hubbellc/ECE44x/README.txt

This is the root folder.
From here you can navigate to a number of well-named folders, containing (hopefully) what you are looking for.
