hubbellc/ECE44x/PCB/README.txt

This folder contains everything utilized in the development of the PCB.
Here you have some basic schematics and images, and then three folders:
	Power holds all the power circuit design
	PCB holds the actual CAD files
		Open using Kicad
	Wiring Design holds the preliminary wiring to get LoRa working
