hubbellc/ECE44x/Wireless Communication/README.txt

This folder contains the user manuals for the Wireless Modules, as well as a variety of testing outputs, and a LoRa range estimator.
