hubbellc/ECE44x/PCB/Power/README.txt

This folder contains all of the power designs.

Progams:
	.asc = LTspice
	
Folder = the kicad design files
	All files in here open in kicad
