hubbellc/ECE44x/Sensor/Sensor Housing/README.txt

This folder contains all files utilized in designing the Sensor Housing.
All files were made using SolidWorks.
There are two additional folders in here, they are included parts that I found online.
