hubbellc/ECE44x/Sensor/Sensor Processing/Sensor Code/README.txt

This is the master folder for all Sensor Code.
It holds a backup of working code, a variety of arduino code, and two additional folders (excluding the arduino file folders).
These two are: Sensor Sandbox, and  Included Libraries.
