hubbellc/ECE44x/Sensor/Sensor Processing/Sensor Code/Included libraries/README.txt

This folder contains all libraries necessary to run the main code "Teensy_Code".
