hubbellc/ECE44x/Sensor/Sensor Processing/Sensor Code/Sensor Sandbox/README.txt

This folder contains all files utilized in testing our integrated sensors.
Play with things!
