hubbellc/ECE44x/Receiver/Receiver Code/cloudtest.docx

The python code below shows the loop that runs on it’s own thread and will upload to the cloud in a loop based on a timer.
