hubbellc/ECE44x/Receiver/Receiver Housing/Housing Ideas.docx

https://www.amazon.com/dp/B07B5ZVS7H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 (https://www.amazon.com/dp/B07B5ZVS7H?s=wireless)

https://www.amazon.com/Raspberry-Case-Black-Compatible-Model/dp/B00UW2G1BS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

Just remove block? Allowed?

Keep shopping.. Look at digikey

https://www.digikey.com/products/en?keywords=raspberry%20pi%203%20case

https://www.digikey.com/products/en/power-supplies-external-internal-off-board/ac-dc-desktop-wall-adapters/130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

https://www.digikey.com/product-detail/en/globtek-inc/WR9MA2000USB-F-R6B/1939-1478-ND/8598281

https://www.digikey.com/products/en/boxes-enclosures-racks/evaluation-development-board-enclosures/975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
