hubbellc/ECE44x/Sensor/Sensor Processing/ch4.docx

I tested the CH4 by hitting the sensor with a blowtorch (with the flame obviously not sparked). The sensor should react to that as it reacts to multiple types of flammable gases including butane. The following data point was taken before and after the blowtorch turned on:

Date/time | Temp | Humidity | Air pressure | Lux | NO2 | CH4
4/18/2019 18:08:13 | 24 | 27 | 101 | 110 | 1 | 30
4/18/2019 18:10:28 | 24 | 28 | 101 | 60 | 1 | 64
