hubbellc/ECE44x/Generated Images/Poster Block Diagram.jpg

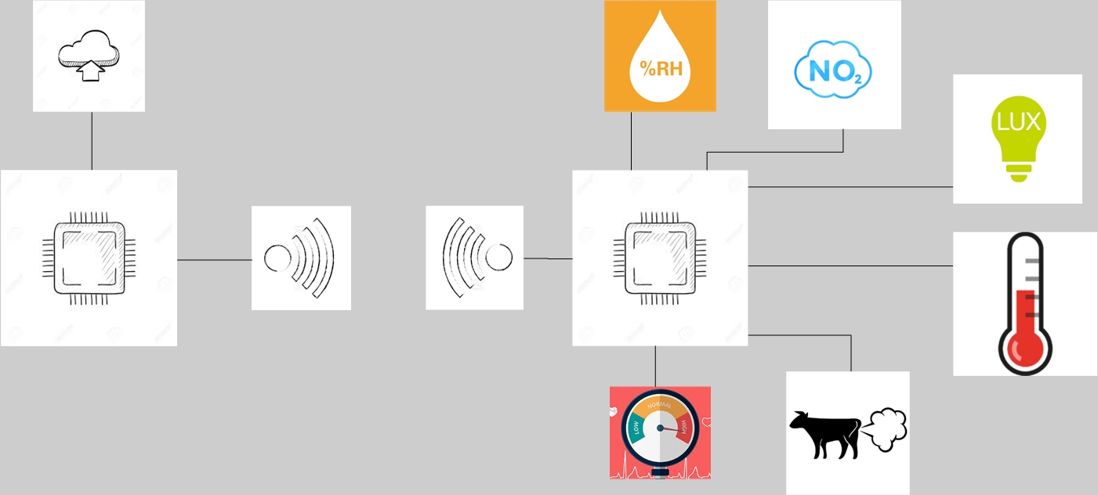
Generated Images/Poster Block Diagram.jpg
