hubbellc/ECE44x/PCB/pcb_pic.PNG

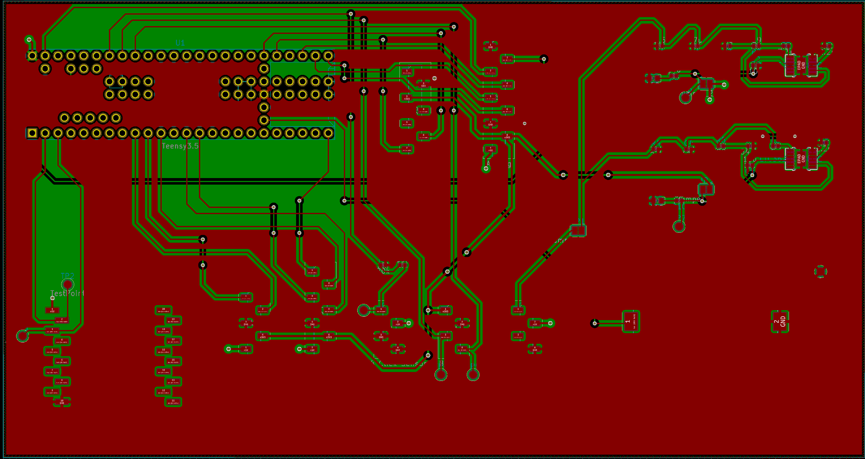
PCB/pcb_pic.PNG
