hubbellc/ECE44x/PCB/Power/power_block.PNG

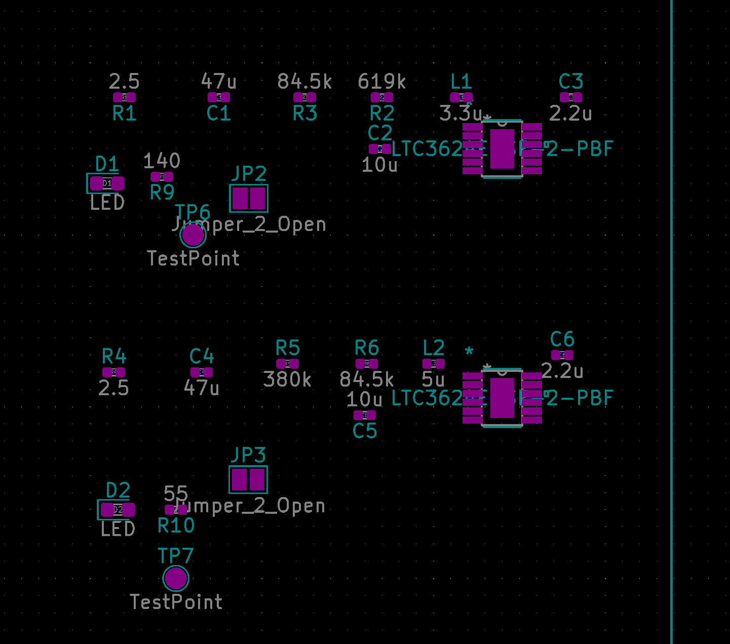
PCB/Power/power_block.PNG
