hubbellc/ECE44x/Sensor/Sensor Housing/Considerations.xlsx

Interface | Item | Size | Panel Thickness | Datasheet | To Buy: | Other Modifications
240V AC PWR | Qualtek 771W-X2/01 | Rectangular - 24.50mm x 12.50mm | (0.60mm ~ 1.50mm) | http://www.qualtekusa.com/images/AC_Receptacles/pdfs/771wx201.pdf | https://octopart.com/search?q=%20Qualtek%20771W-X2%2F01 | Nail Hole (2) | TRUE
12V DC PWR | GC Electronics 33-1402 | Rectangular - 57mm x 57mm | N/A | https://media.digikey.com/pdf/Data%20Sheets/GC%20Electronics%20PDFs/33-1402_Dwg.pdf | https://octopart.com/search?q=GC%20Electronics%2033-1402 | Air ventilation | TRUE
Antenna conn | PulseLarsen Antennas W9011M | 5.49mm circle | N/A | https://productfinder.pulseeng.com/doc_type/WEB301/doc_num/W90XX/doc_part/W90XX.pdf | https://octopart.com/search?q=W9011M | Light window | TRUE
 |  |  |  |  |  | Power components? | TRUE
US plug: | Phihong USA AC15WNA | N/A | N/A | https://media.digikey.com/pdf/Data%20Sheets/Phihong%20PDFs/AC15WNA.pdf | https://octopart.com/search?q=Phihong%20USA%20AC15WNA
Thailand plug: | Phihong USA AC15WEU | N/A | N/A | https://media.digikey.com/pdf/Data%20Sheets/Phihong%20PDFs/AC_Line_Cords.pdf | https://octopart.com/search?q=Phihong%20USA%20AC15WEU
Antenna | PulseLarsen Antennas SPDA24918 | N/A | N/A | http://productfinder.pulseeng.com/products/datasheets/SPDA24918.pdf | https://octopart.com/search?q=SPDA24918
