hubbellc/ECE44x/Sensor/Sensor Processing/SD Card Space.xlsx

Size: | Amount: | Size per write: | Max: | Writes: | Writes a day: | Days of writes: | Years of writes:
1.2 | 31 | 0.03871 | 8000000 | 207000000 | 288 | 718000 | 1910
KB |  | KB | KB
