hubbellc/ECE44x/Sensor/Sensor Housing/hirose-u-fl-female-jack-to-sma-female-jack-bulkhead-rf-adapter-1.snapshot.6/U.FL Female Jack to SMA Female Jack Bulkhead RF Connector.SLDASM

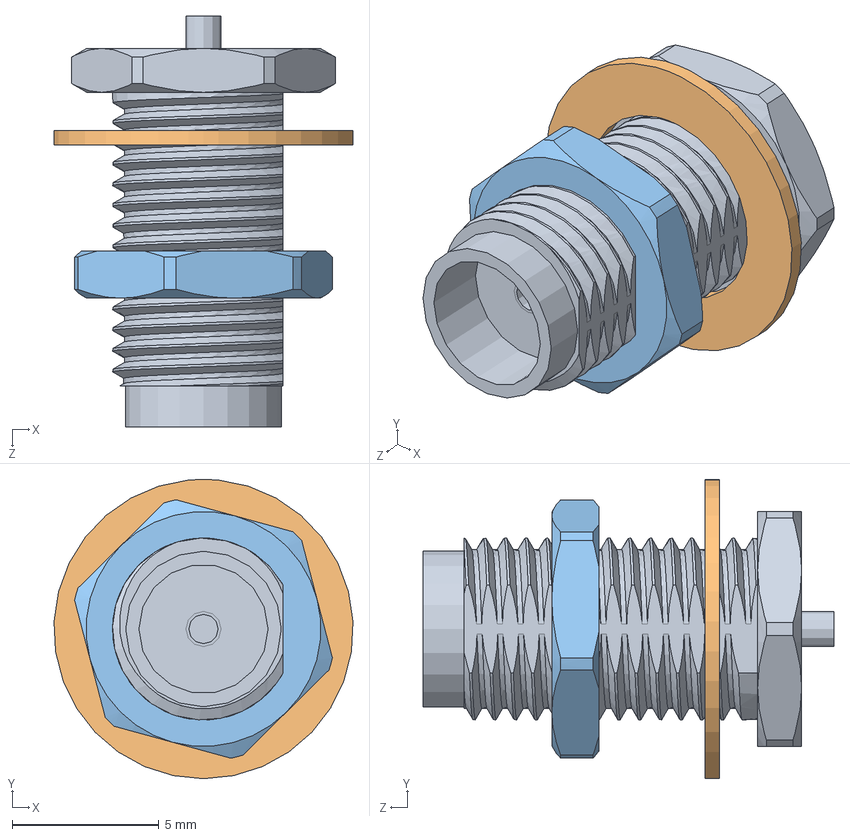
[picture p4: CAD file, 2019-02-04]
Sensor/Sensor Housing/hirose-u-fl-female-jack-to-sma-female-jack-bulkhead-rf-adapter-1.snapshot.6/U.FL Female Jack to SMA Female Jack Bulkhead RF Connector.SLDASM
10.2 x 10.2 x 14.0 mm
U.FL to SMA Bulkhead
U.FL to SMA Bulkhead Washer
U.FL to SMA Bulkhead Nut
