hubbellc/ECE44x/Sensor/Sensor Housing/Sensor Housing.SLDASM

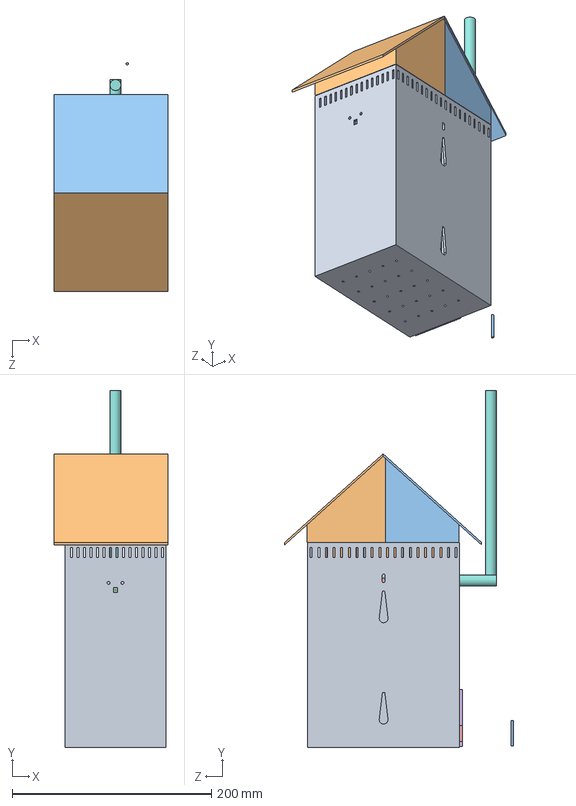
[picture p5: CAD file, 2019-05-01]
Sensor/Sensor Housing/Sensor Housing.SLDASM
114.3 x 358.1 x 229.4 mm
Base
Door
Light sensor
AC Plug
DC Plug
U.FL to SMA Bulkhead
Antenna
Light sensor washers
Roof1
Roof2
PCB Holder
SOLID.step x 2
SOLID-0.step x 10
SOLID-1.step x 2
SOLID-2.step
SOLID-3.step x 3
SOLID-4.step
SOLID-5.step x 6
SOLID-6.step x 2
COMPOUND.step
