hubbellc/ECE44x/Sensor/Sensor Housing/PCB.SLDASM

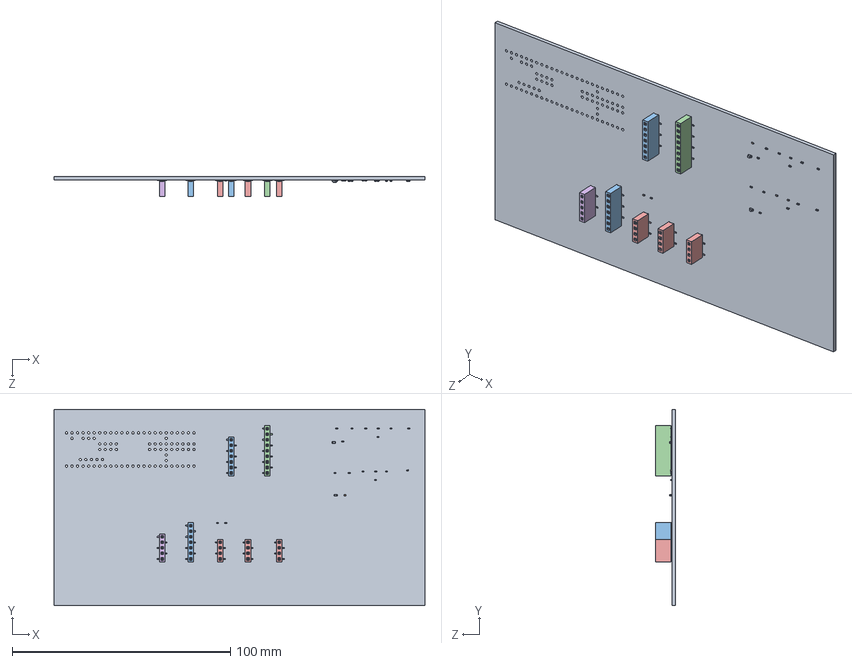
[picture p6: CAD file, 2019-05-01]
Sensor/Sensor Housing/PCB.SLDASM
170.0 x 90.0 x 9.05 mm
SOLID.step x 2
SOLID-0.step x 10
SOLID-1.step x 2
SOLID-2.step
SOLID-3.step x 3
SOLID-4.step
SOLID-5.step x 6
SOLID-6.step x 2
COMPOUND.step
