hubbellc/ECE44x/Sensor/Sensor Housing/House on post.SLDASM

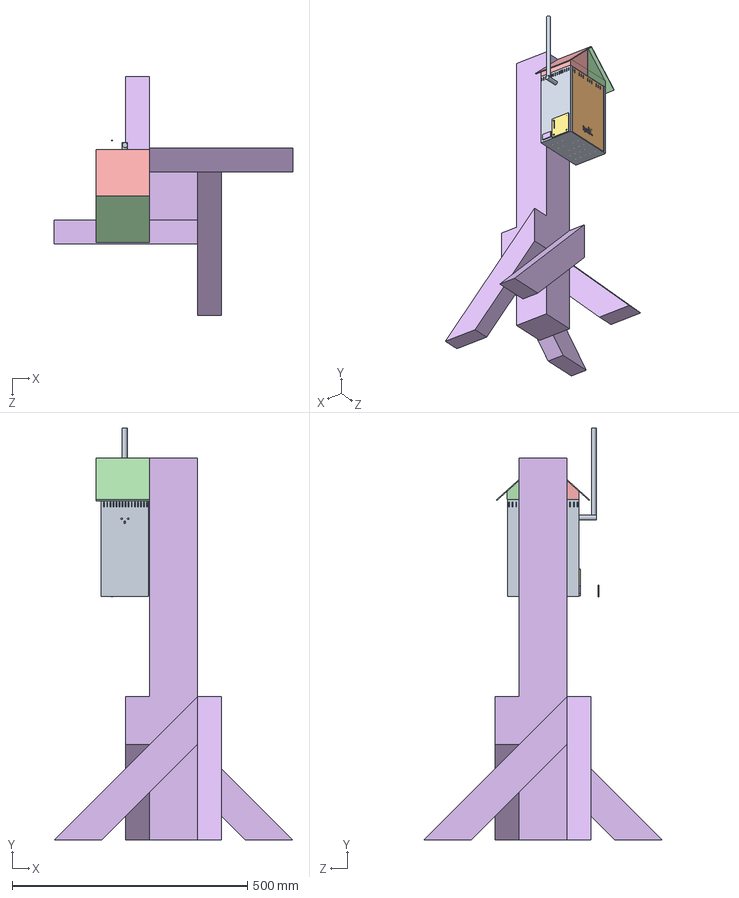
[picture p7: CAD file, 2019-02-22]
Sensor/Sensor Housing/House on post.SLDASM
508.0 x 876.3 x 508.0 mm
Base
Door
PCB
Light sensor
AC Plug
DC Plug
U.FL to SMA Bulkhead
Antenna
PCB washers
Light sensor washers
Roof1
Roof2
Stand
