hubbellc/ECE44x/Generated Images/raitong-intro-logo-detailed.dxf

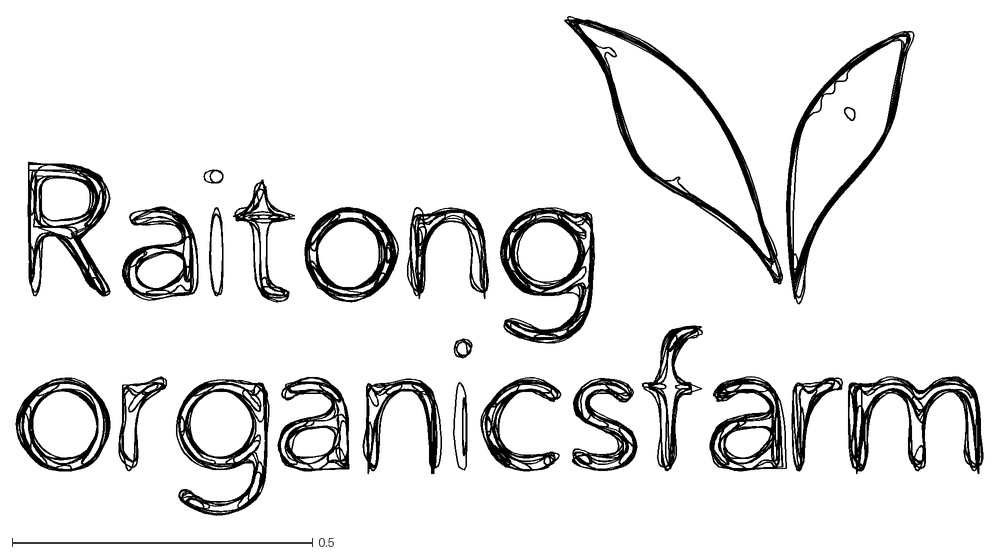
[picture p8: CAD file, 2019-02-14]
Generated Images/raitong-intro-logo-detailed.dxf
1.62 x 0.831
