hubbellc/ECE44x/Sensor/Sensor Housing/User Library-VEML6070_UV/User Library-VEML6070_UV.SLDPRT

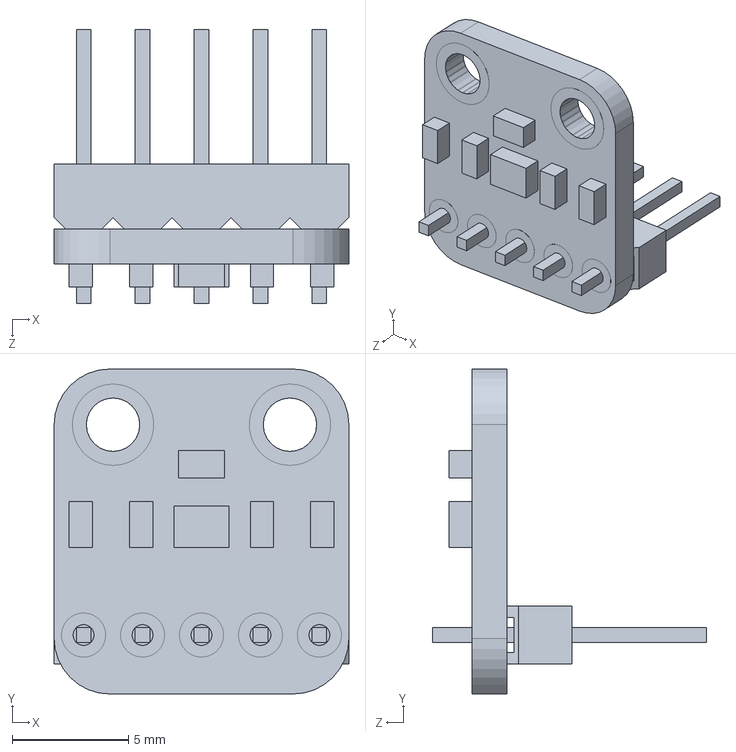
[picture p9: CAD file, 2019-02-04]
Sensor/Sensor Housing/User Library-VEML6070_UV/User Library-VEML6070_UV.SLDPRT
12.7 x 14.0 x 11.8 mm
