hubbellc/ECE44x/Generated Images/raitong-intro-logo-simple.dxf

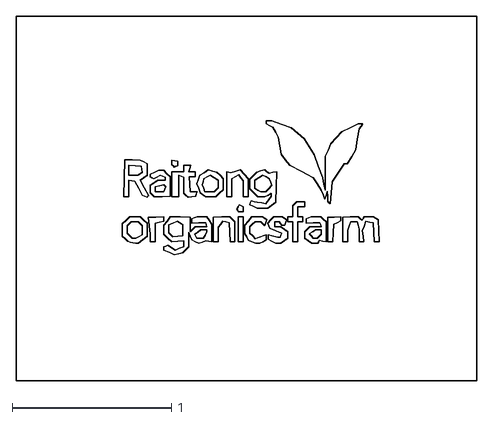
[picture p10: CAD file, 2019-02-14]
Generated Images/raitong-intro-logo-simple.dxf
2.90 x 2.29
