hubbellc/ECE44x/Sensor/Sensor Housing/Light sensor.SLDPRT

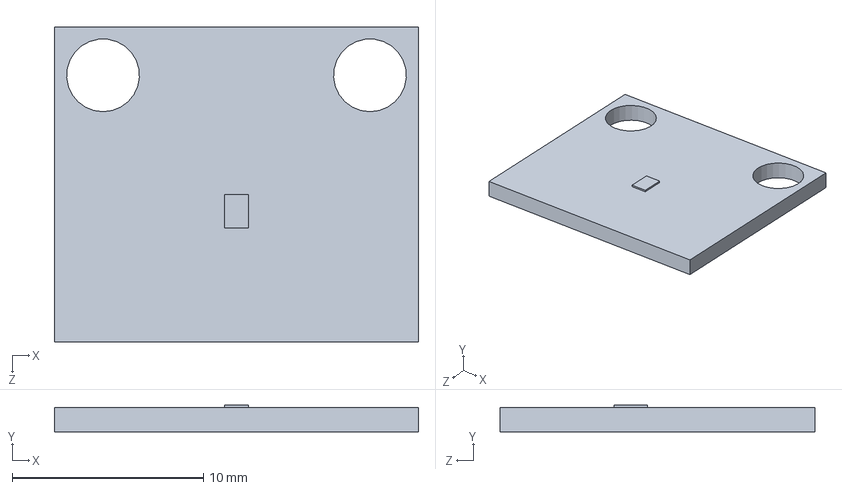
[picture p11: CAD file, 2019-05-01]
Sensor/Sensor Housing/Light sensor.SLDPRT
19.0 x 1.40 x 16.5 mm
