hubbellc/ECE44x/Sensor/Sensor Housing/hirose-u-fl-female-jack-to-sma-female-jack-bulkhead-rf-adapter-1.snapshot.6/U.FL to SMA Bulkhead.SLDPRT

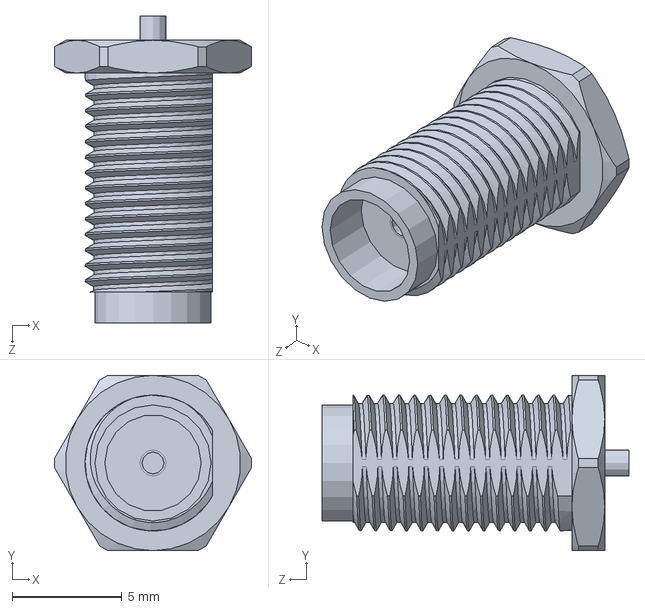
[picture p12: CAD file, 2019-02-04]
Sensor/Sensor Housing/hirose-u-fl-female-jack-to-sma-female-jack-bulkhead-rf-adapter-1.snapshot.6/U.FL to SMA Bulkhead.SLDPRT
8.99 x 8.00 x 14.0 mm
