hubbellc/ECE44x/Sensor/Sensor Housing/Door no logo.SLDPRT

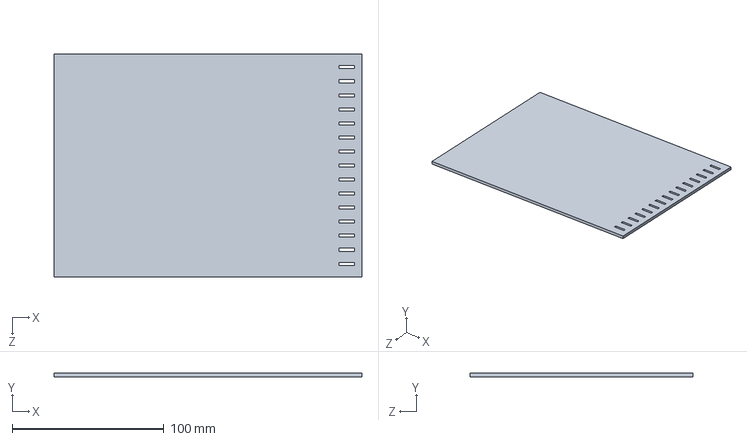
[picture p13: CAD file, 2019-04-10]
Sensor/Sensor Housing/Door no logo.SLDPRT
203.2 x 2.54 x 146.9 mm
