hubbellc/ECE44x/Sensor/Sensor Housing/PCB Holder.SLDPRT

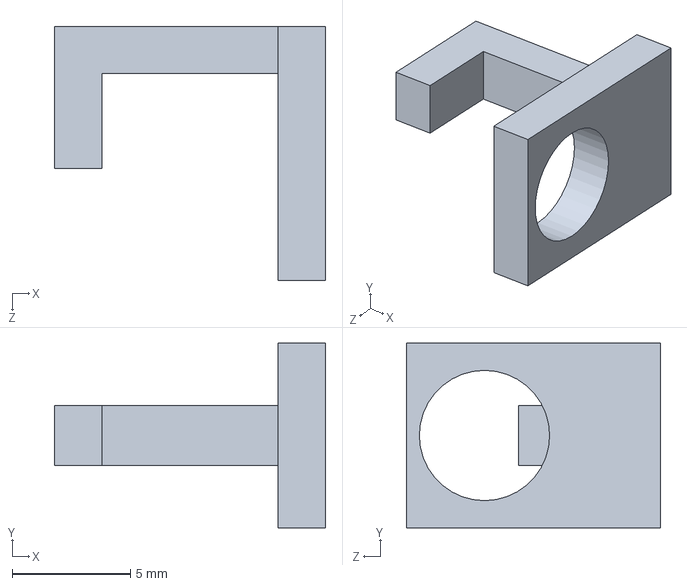
[picture p14: CAD file, 2019-04-10]
Sensor/Sensor Housing/PCB Holder.SLDPRT
11.4 x 7.81 x 10.7 mm
