hubbellc/ECE44x/Sensor/Sensor Housing/Base.SLDPRT

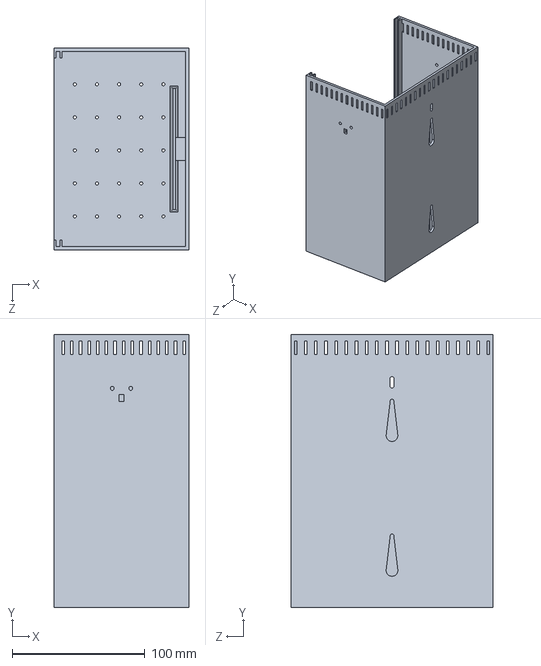
[picture p15: CAD file, 2019-04-10]
Sensor/Sensor Housing/Base.SLDPRT
101.6 x 205.7 x 152.4 mm
