hubbellc/ECE44x/Sensor/Sensor Housing/Stand.SLDPRT

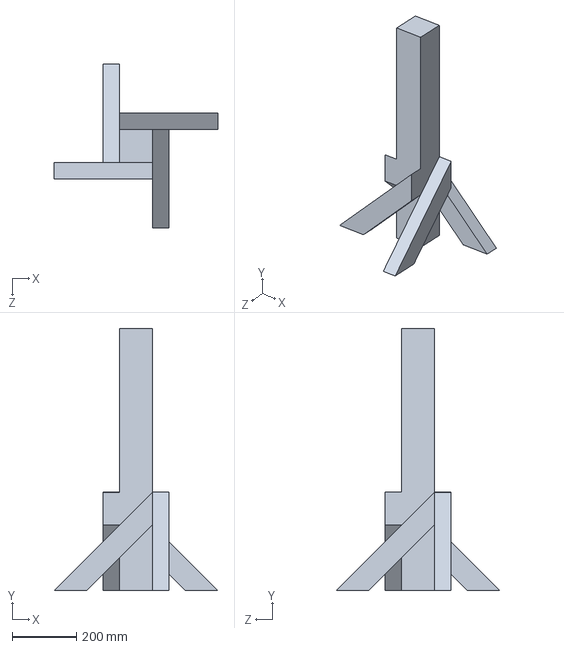
[picture p16: CAD file, 2019-02-22]
Sensor/Sensor Housing/Stand.SLDPRT
508.0 x 812.8 x 508.0 mm
