hubbellc/ECE44x/Sensor/Sensor Housing/Roof1.sldprt

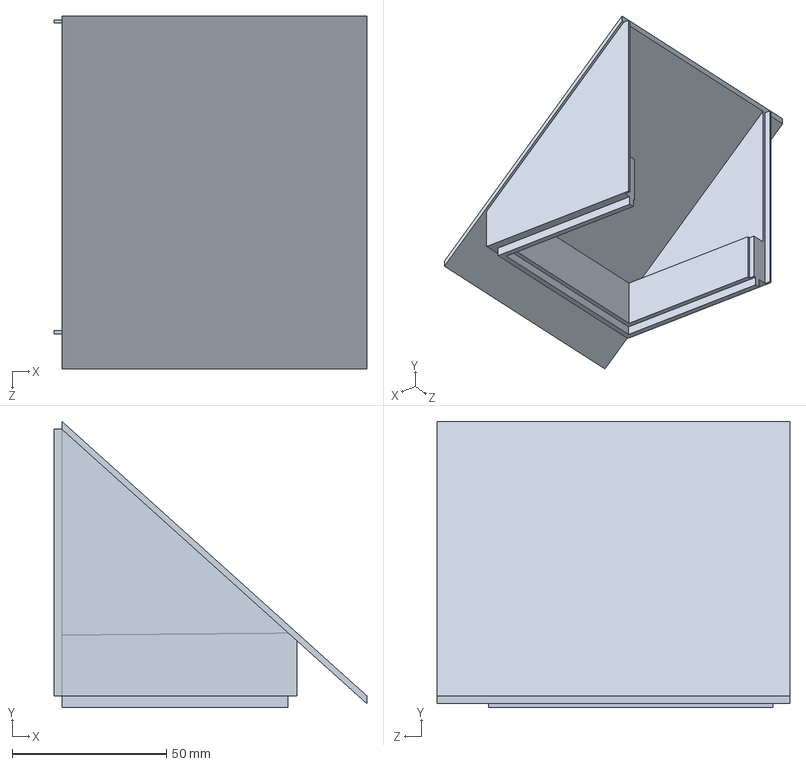
[picture p17: CAD file, 2019-02-22]
Sensor/Sensor Housing/Roof1.sldprt
101.3 x 92.7 x 114.3 mm
