hubbellc/ECE44x/Sensor/Sensor Housing/Roof.SLDPRT

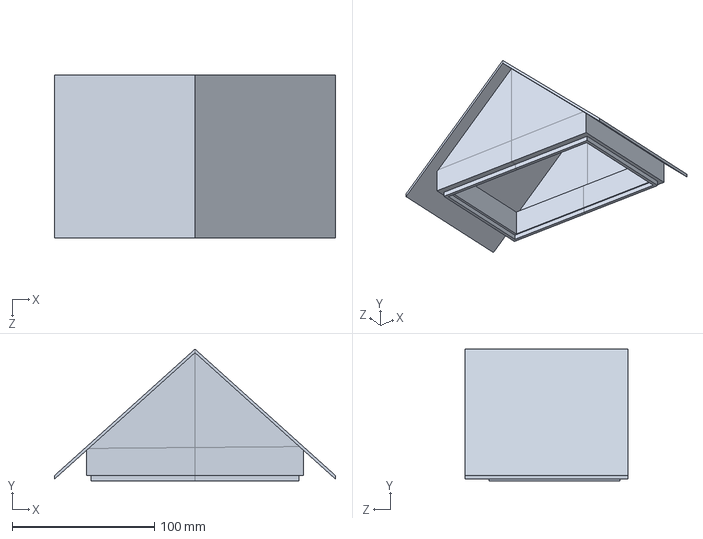
[picture p18: CAD file, 2019-02-22]
Sensor/Sensor Housing/Roof.SLDPRT
197.6 x 92.7 x 114.3 mm
