hubbellc/ECE44x/Sensor/Sensor Housing/Gecko.SLDPRT

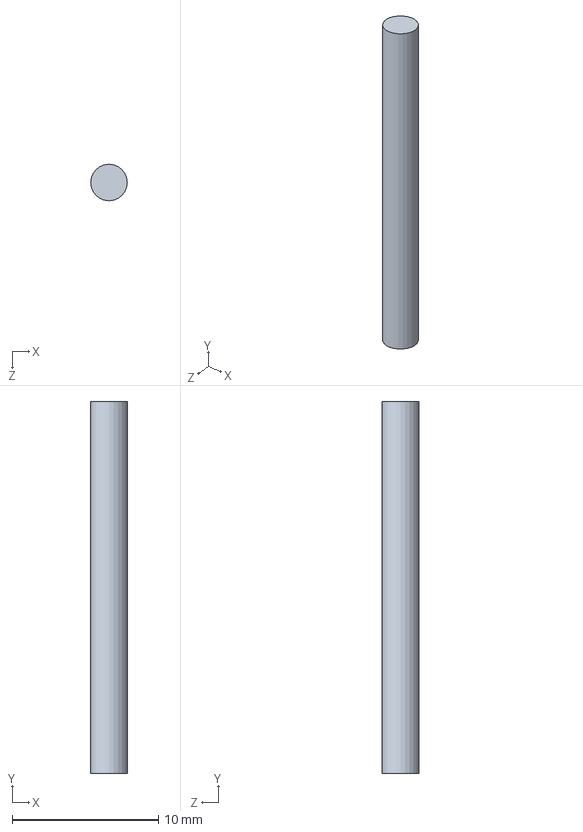
[picture p19: CAD file, 2019-02-14]
Sensor/Sensor Housing/Gecko.SLDPRT
2.50 x 25.4 x 2.50 mm
