hubbellc/ECE44x/Sensor/Sensor Housing/Antenna.SLDPRT

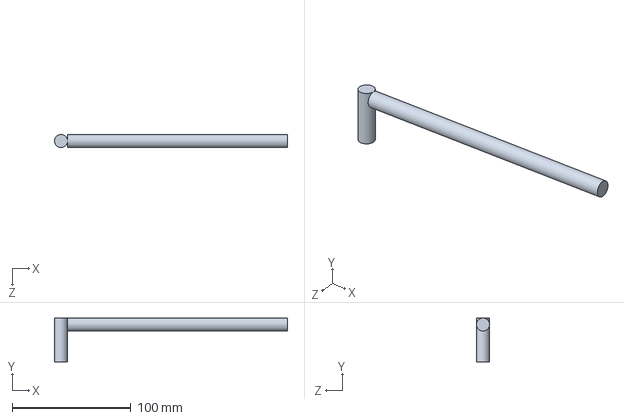
[picture p20: CAD file, 2019-02-14]
Sensor/Sensor Housing/Antenna.SLDPRT
196.0 x 37.0 x 11.0 mm
