hubbellc/ECE44x/Sensor/Sensor Housing/AC Plug.SLDPRT

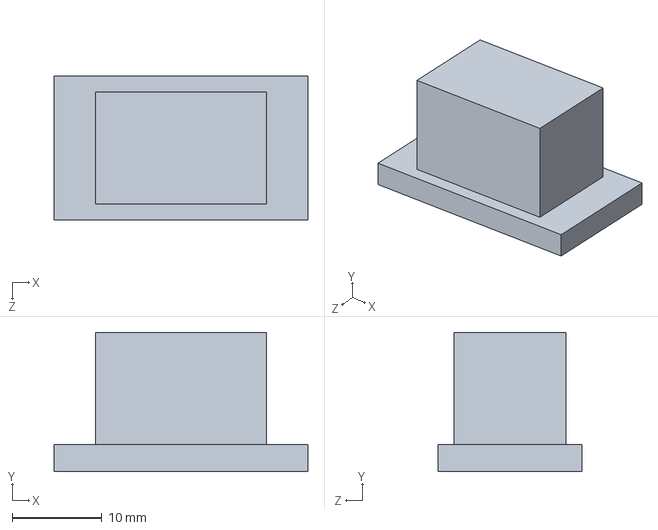
[picture p21: CAD file, 2019-02-14]
Sensor/Sensor Housing/AC Plug.SLDPRT
28.3 x 15.5 x 16.0 mm
