hubbellc/ECE44x/Sensor/Sensor Housing/DC Plug.SLDPRT

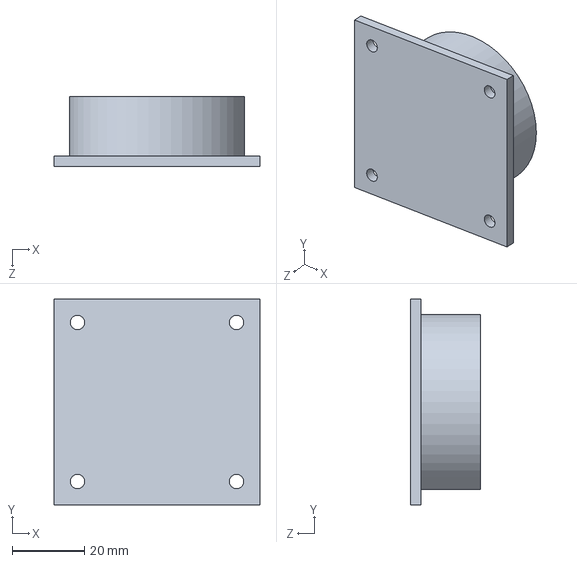
[picture p22: CAD file, 2019-02-04]
Sensor/Sensor Housing/DC Plug.SLDPRT
57.0 x 57.0 x 19.5 mm
