hubbellc/ECE44x/(list of files, cad)

Other CAD files:
Sensor/Sensor Housing/Door.SLDPRT
Sensor/Sensor Housing/Roof2.sldprt
Sensor/Sensor Housing/Base.STL
Sensor/Sensor Housing/Door no logo.DXF
Sensor/Sensor Housing/Door.STL
Sensor/Sensor Housing/Gecko.STL
Sensor/Sensor Housing/Light sensor washers.SLDPRT
Sensor/Sensor Housing/Light sensor washers.STL
Sensor/Sensor Housing/PCB Holder.STL
Sensor/Sensor Housing/PCB washers.SLDPRT
Sensor/Sensor Housing/PCB washers.STL
Sensor/Sensor Housing/PCB.SLDPRT
Sensor/Sensor Housing/Roof1.STL
Sensor/Sensor Housing/Roof2.STL
Sensor/Sensor Housing/hirose-u-fl-female-jack-to-sma-female-jack-bulkhead-rf-adapter-1.snapshot.6/U.FL to SMA Bulkhead Nut.SLDPRT
Sensor/Sensor Housing/hirose-u-fl-female-jack-to-sma-female-jack-bulkhead-rf-adapter-1.snapshot.6/U.FL to SMA Bulkhead Washer.SLDPRT
