hubbellc/ECE44x/PCB/Wiring Design/README.txt

This folder contains all of the wiring diagrams and PCB designs.

Progams:
	.vsdx = Microsoft Visio
