hubbellc/ECE44x/PCB/wiring_schem_pic.PNG

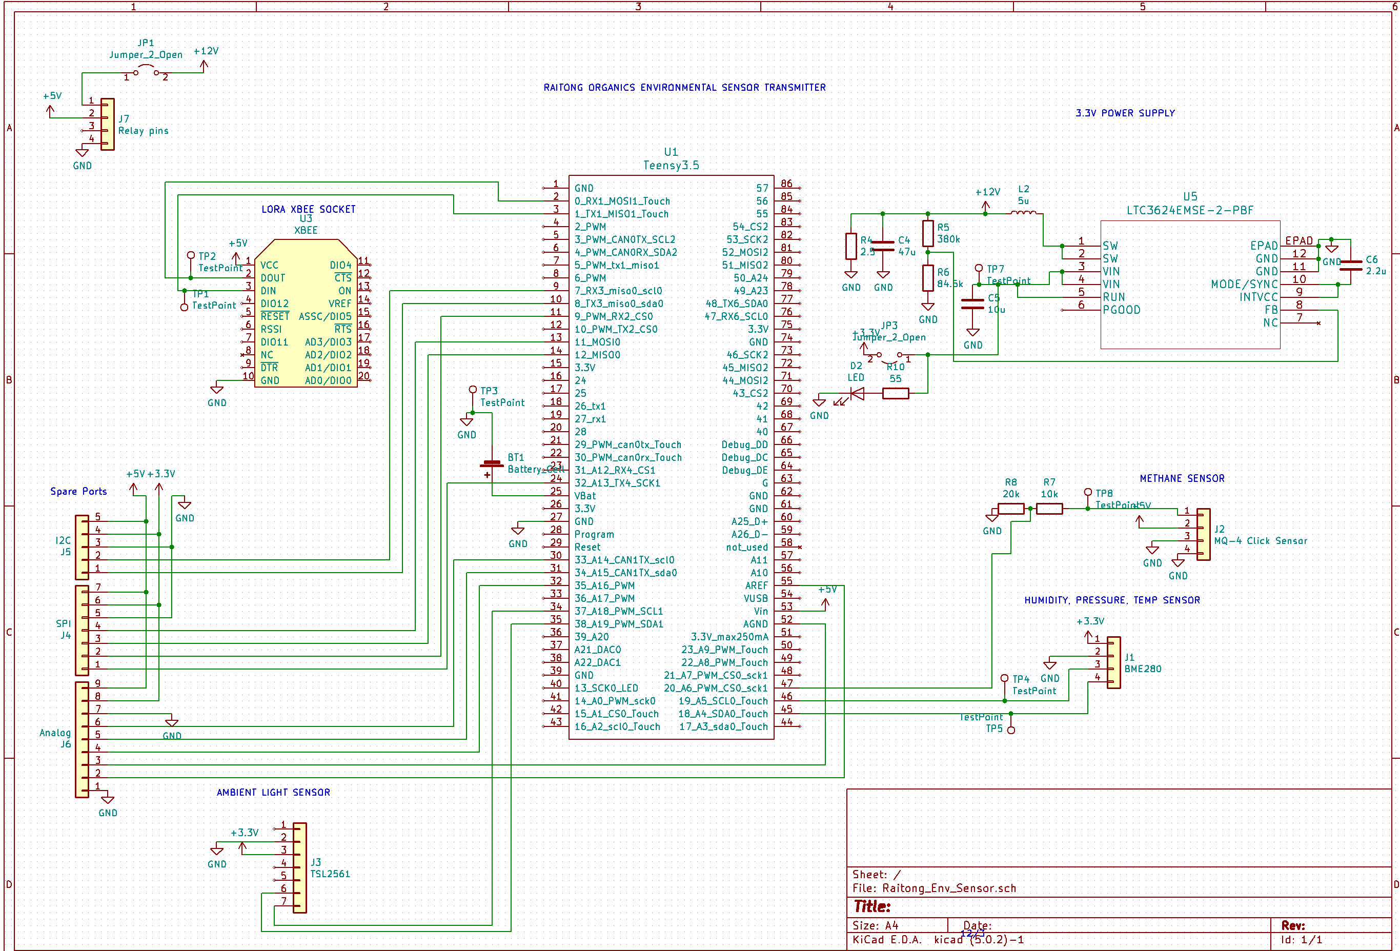
PCB/wiring_schem_pic.PNG
