hubbellc/ECE44x/Sensor/Sensor Housing/ER 13 Validation.docx

I utilized a wooden post with 2 screws in it to hang the sensor housing. This was timed as I took the video, and it took less than 10 seconds, which is way under our limit of 5 minutes.

Please see the video linked below for proof of testing: https://drive.google.com/a/oregonstate.edu/file/d/1FUkLCJCY3Q7YTJLb_LxiFsOcxymKo7cK/view?usp=sharing
