hubbellc/ECE44x/Sensor/Sensor Housing/ER 15 Validation.docx

Based on the footprint of the device, and the fact that it does not create any frequency, nor heat, it will not harm the pigs.
