hubbellc/ECE44x/Sensor/Sensor Housing/ER 4 Validation.docx

Using the inspection tool on Solidworks, I looked for any hole exceeding 2.5mm in diameter. None were found. This was also tested using a 2.5mm diameter cylinder.

Please see the video linked below for proof of testing: https://drive.google.com/a/oregonstate.edu/file/d/1FUkLCJCY3Q7YTJLb_LxiFsOcxymKo7cK/view?usp=sharing
