hubbellc/ECE44x/Receiver/Receiver Code/test.csv

Date/time | Temp | Humidity | Air pressure | Lux | NO2 | CH4
01/01/1997 06:30:23 | 10 | 14 | 19 | 70 | 0 | 60
01/01/1997 06:30:23 | 10 | 14 | 19 | 70 | 0 | 60
01/01/1997 06:30:23 | 10 | 14 | 19 | 70 | 0 | 60
01/01/1997 06:30:23 | 10 | 14 | 19 | 70 | 0 | 60
