hubbellc/ECE44x/Wireless Communication/LoRa Testing.txt

⸮
Connection successful
Programming complete
10:24:58
10:25:01
10:25:04
10:25:07
10:25:13
10:25:19
10:25:22
10:25:25
10:25:34
10:25:37
10:25:40
10:25:46
10:25:49
10:25:58
10:26:01
10:26:07
10:26:13
10:26:19
10:26:22
10:26:28
10:26:31
10:26:40
10:26:49
10:26:55
10:26:58
10:27:01
10:27:04
10:27:13
10:27:16
10:27:19
10:27:25
10:27:34
10:27:37
10:27:40
10:27:52
10:27:55
10:28:04
10:28:07
10:28:10
10:28:13
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
