hubbellc/ECE44x/Receiver/Receiver Housing/ER 14 Validation.docx

This was tested using a ruler, and the system was shown to not exceed expectations.

Please see the video linked below for proof of testing: https://drive.google.com/a/oregonstate.edu/file/d/1FSmPCz0hXOeB65JWNN9Inm89Fj9V4-E_/view?usp=sharing
