hubbellc/ECE44x/Sensor/Sensor Processing/ER 18 Validation.docx

The system was plugged into the wall and a computer and left alone for 12 hours. Using the computer as a serial receiver, we collected 12 hours of data from the system as it ran. Below is the transcript showing successful operation.

By testing 12 hours, and seeing no issues, we can easily assume that the system will also operate for 24 hours with no issue.

At the end of the run, the time was evaluated to be 2 seconds off, or an error of 0.0009%, which is well within our 2% limit.

Transcript:

Connection successful

mDot programming complete

Time set: 1/19/2019 22:33:58

SD initialized

---------------------beginning main loop--------------------

Writing data to LoRa...Writing data to SD...done.

22:35:48.002 -> Writing data to LoRa...Writing data to SD...done.

22:36:47.972 -> Writing data to LoRa...Writing data to SD...done.

22:37:47.976 -> Writing data to LoRa...Writing data to SD...done.

22:38:47.978 -> Writing data to LoRa...Writing data to SD...done.

22:39:47.978 -> Writing data to LoRa...Writing data to SD...done.

22:40:47.982 -> Writing data to LoRa...Writing data to SD...done.

22:41:47.988 -> Writing data to LoRa...Writing data to SD...done.

22:42:47.990 -> Writing data to LoRa...Writing data to SD...done.

22:43:47.994 -> Writing data to LoRa...Writing data to SD...done.

22:44:47.998 -> Writing data to LoRa...Writing data to SD...done.

22:45:47.993 -> Writing data to LoRa...Writing data to SD...done.

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

13:01:48.769 -> Writing data to LoRa...Writing data to SD...done.

13:02:48.768 -> Writing data to LoRa...Writing data to SD...done.

13:03:48.772 -> Writing data to LoRa...Writing data to SD...done.

13:04:48.773 -> Writing data to LoRa...Writing data to SD...done.

13:05:48.777 -> Writing data to LoRa...Writing data to SD...done.

13:06:48.777 -> Writing data to LoRa...Writing data to SD...done.

13:07:48.772 -> Writing data to LoRa...Writing data to SD...done.

13:08:48.773 -> Writing data to LoRa...Writing data to SD...done.

13:09:48.773 -> Writing data to LoRa...Writing data to SD...done.
