hubbellc/ECE44x/PCB/Wiring Design/Transmitter Wiring.pdf

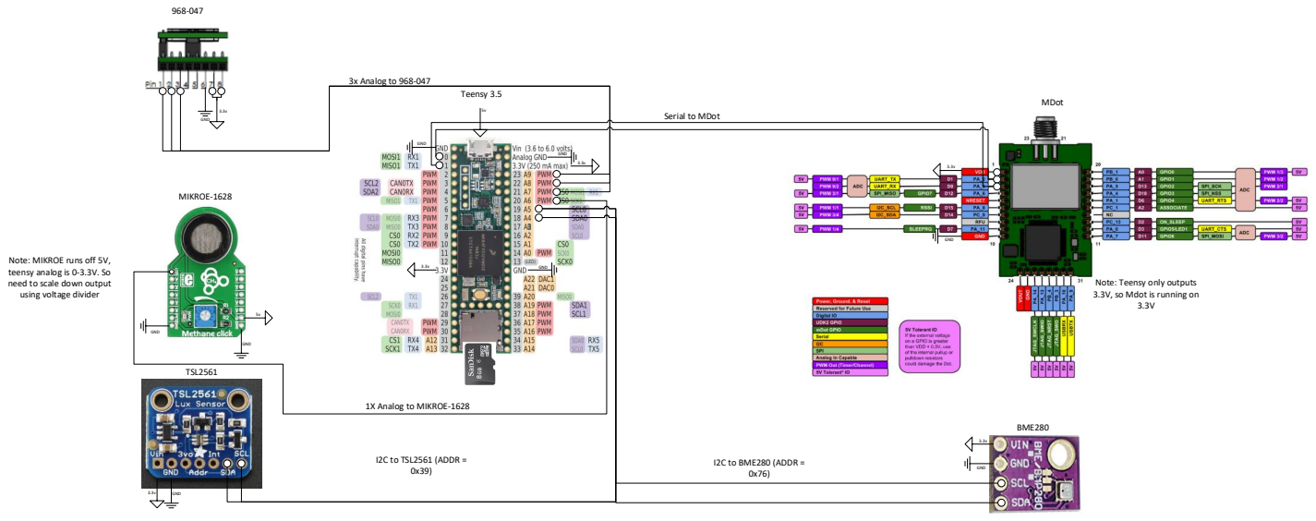
[picture p30: page 1]
Teensy 3.5; MDot; BME280; GND; I2C to BME280 (ADDR = 0x76); 3x Analog to 968-047; GND 3.3v; I2C to TSL2561 (ADDR = 0x39); TSL2561; MIKROE-1628

Serial to MDot

Note: MIKROE runs off 5V,
teensy analog is 0-3.3V. So
need to scale down output
using voltage divider

Note: Teensy only outputs
3.3V, so Mdot is running on

1X Analog to MIKROE-1628
