hubbellc/ECE44x/PCB/Preliminary Schematic.pdf

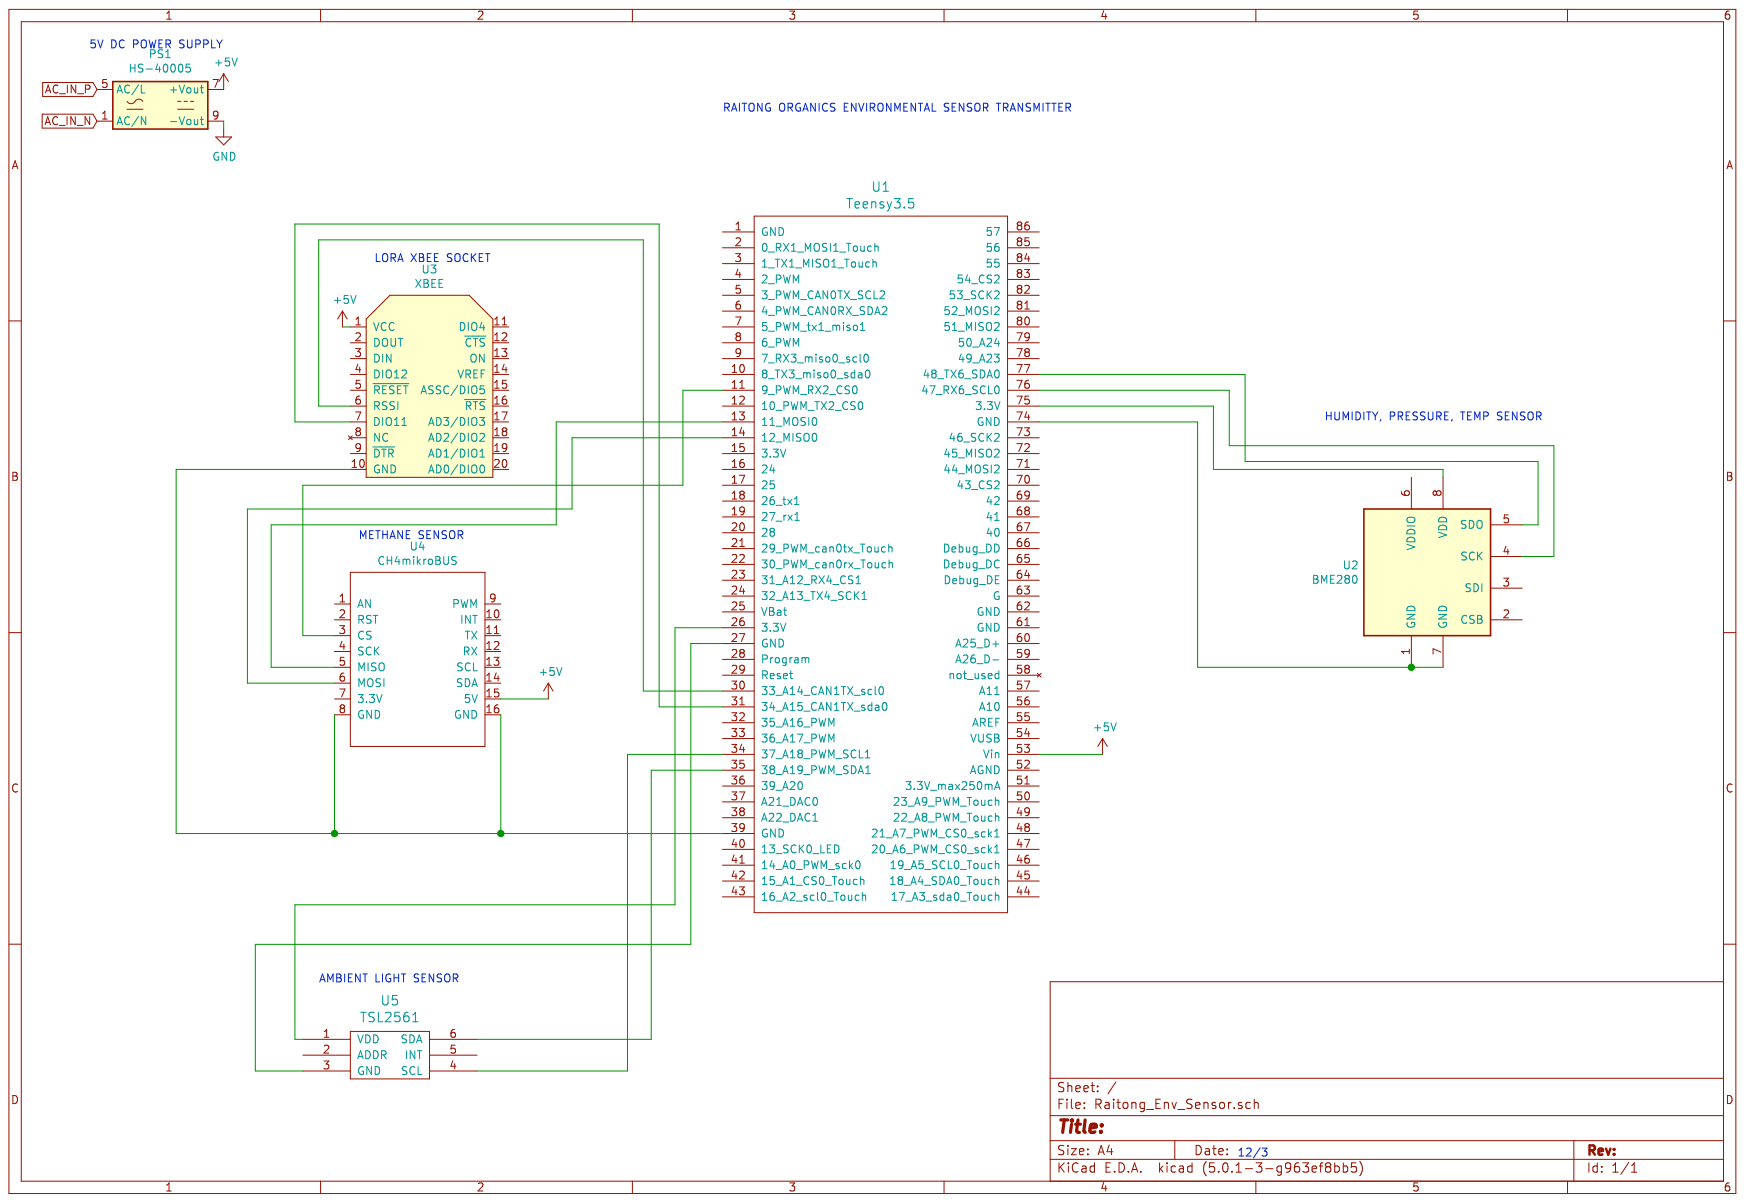
[picture p31: page 1]
