hubbellc/ECE44x/Sensor/Sensor Housing/Sensor Housing Exploded.PDF

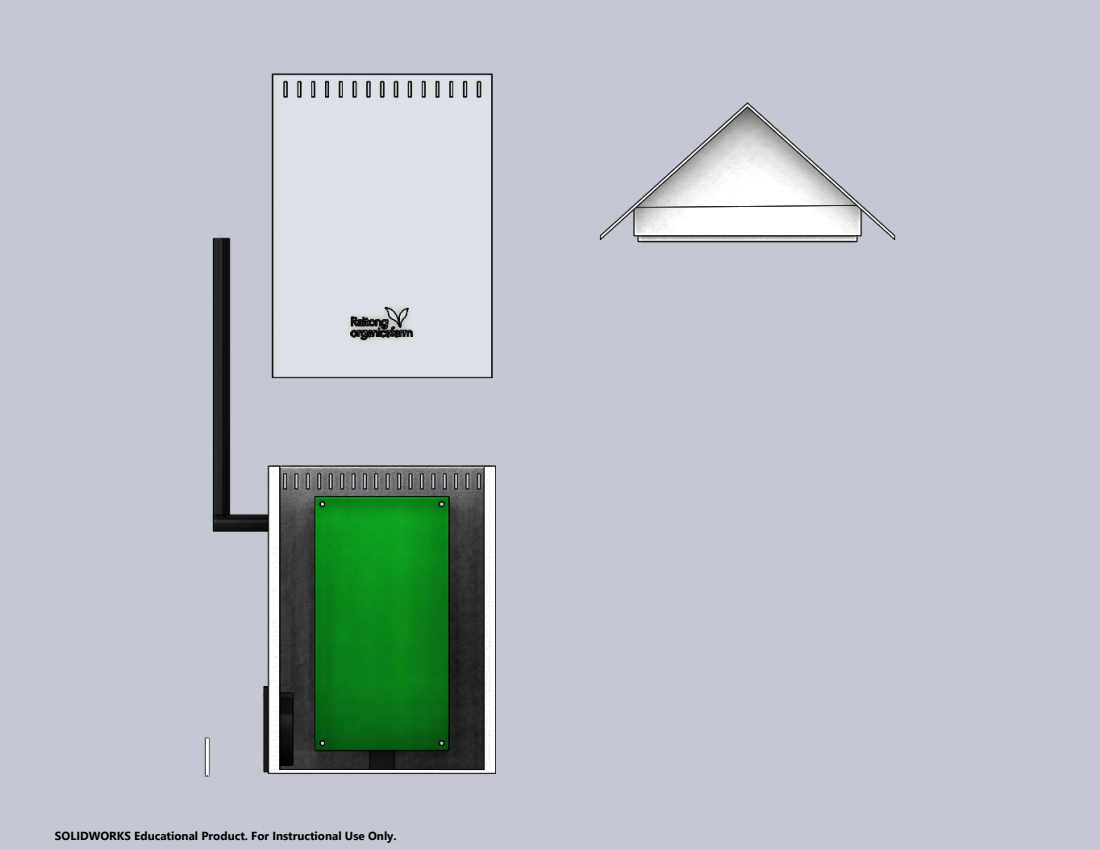
[picture p32: page 1]

SOLIDWORKS Educational Product. For Instructional Use Only.
