hubbellc/ECE44x/Sensor/Sensor Housing/Sensor Housing Front.PDF

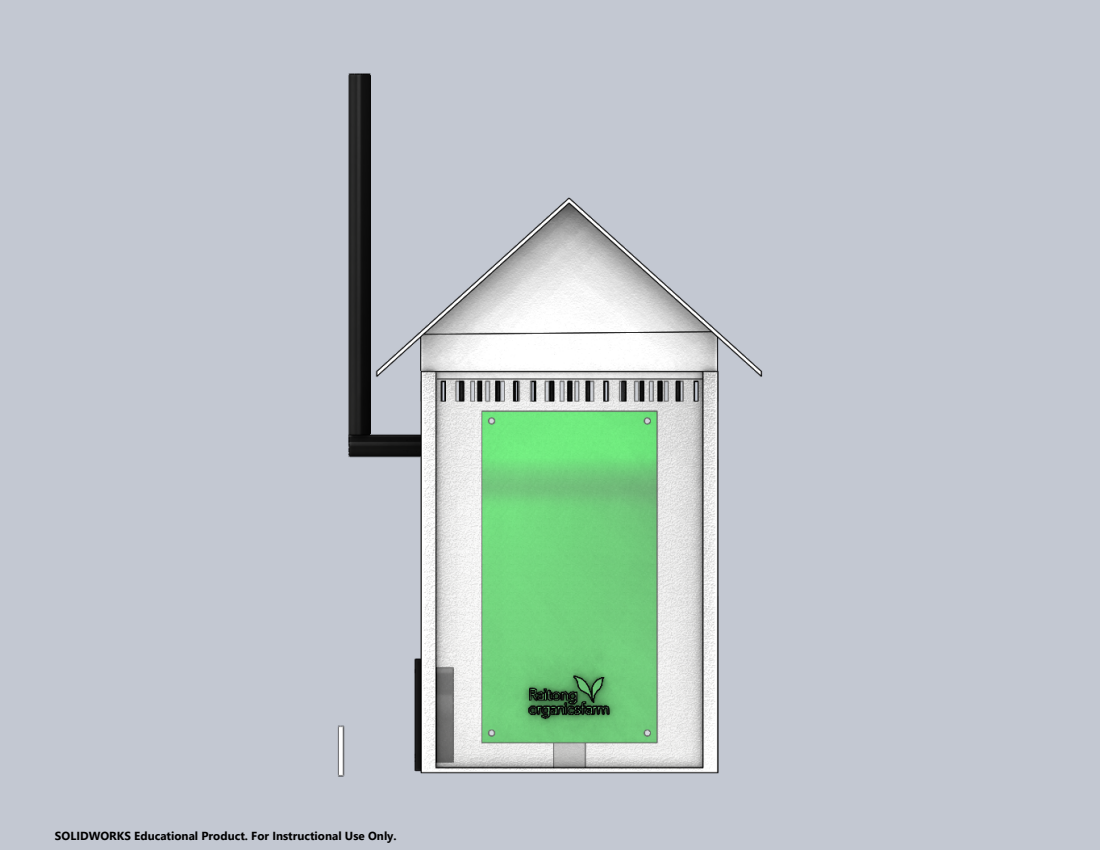
[picture p33: page 1]

SOLIDWORKS Educational Product. For Instructional Use Only.
