hubbellc/ECE44x/Sensor/Sensor Housing/Sensor Housing Left.PDF

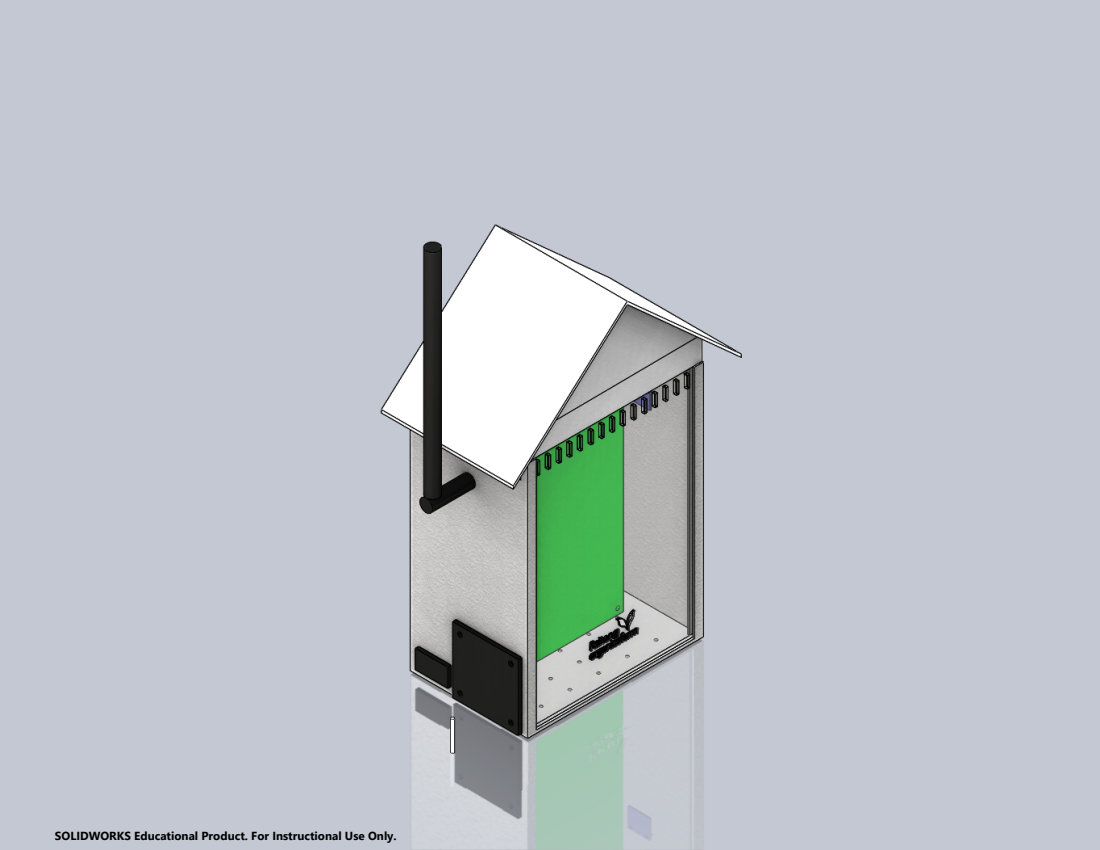
[picture p34: page 1]

SOLIDWORKS Educational Product. For Instructional Use Only.
