hubbellc/ECE44x/Sensor/Sensor Housing/Sensor Housing Right.PDF

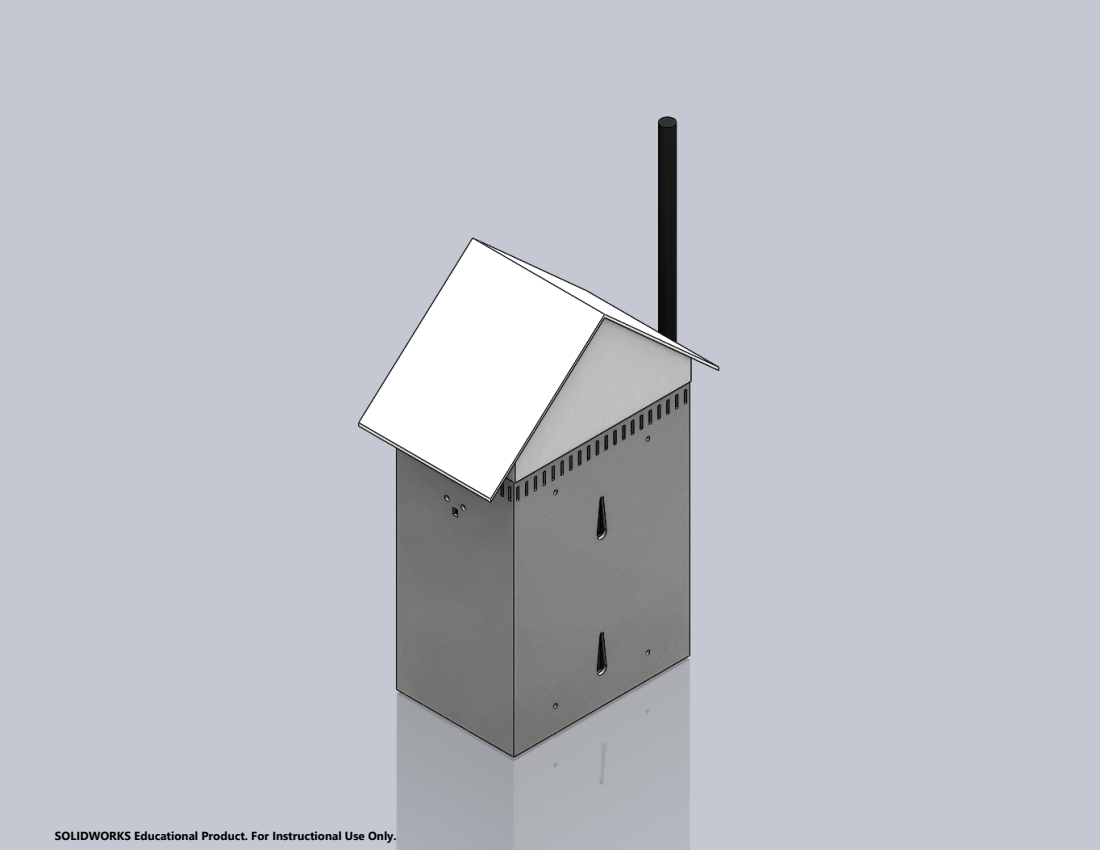
[picture p35: page 1]

SOLIDWORKS Educational Product. For Instructional Use Only.
