hubbellc/ECE44x/PCB/Power/voltgage reg.asc

C1: cap; 10µ
C2: cap; 47µ
C3: cap; 2.2µ
C4: cap; 10µ
C5: cap; 47µ
C6: cap; 2.2µ
L1: ind; 3.3µ
L2: ind; 5µ
R1: res; 2.5
R2: res; 619k
R3: res; 84.5k
R4: res; 2.5
R5: res; 380k
R6: res; 84.5k
U1: LTC3624
U2: LTC3624
V1: voltage; 12
Named nets: 0, 5Vout, 3.3Vout
.tran 500u
;tran 500u
5V
3.3V
