hubbellc/ECE44x/PCB/PCB/Raitong_Env_Sensor.kicad_pcb

## KiCad design PCB/PCB/Raitong_Env_Sensor.kicad_pcb (2019-05-28)

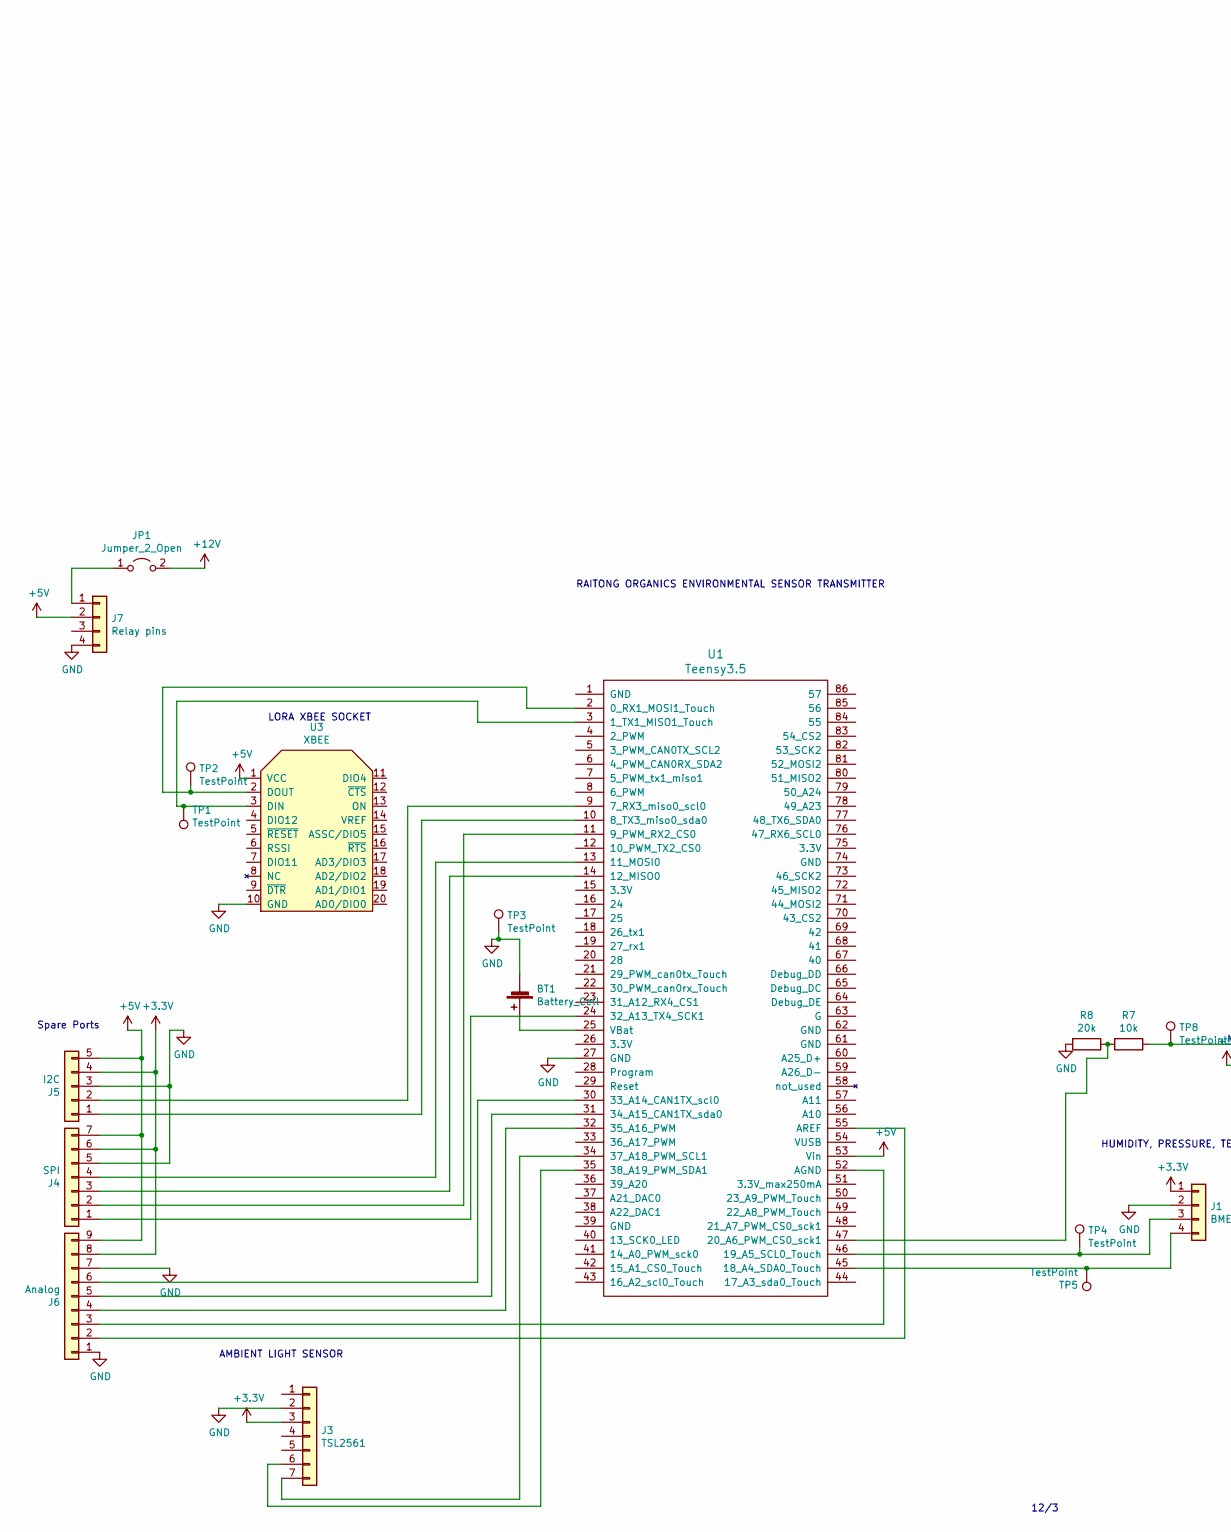
[picture p36: schematic Raitong_Env_Sensor.sch, part in row 1, column 1]

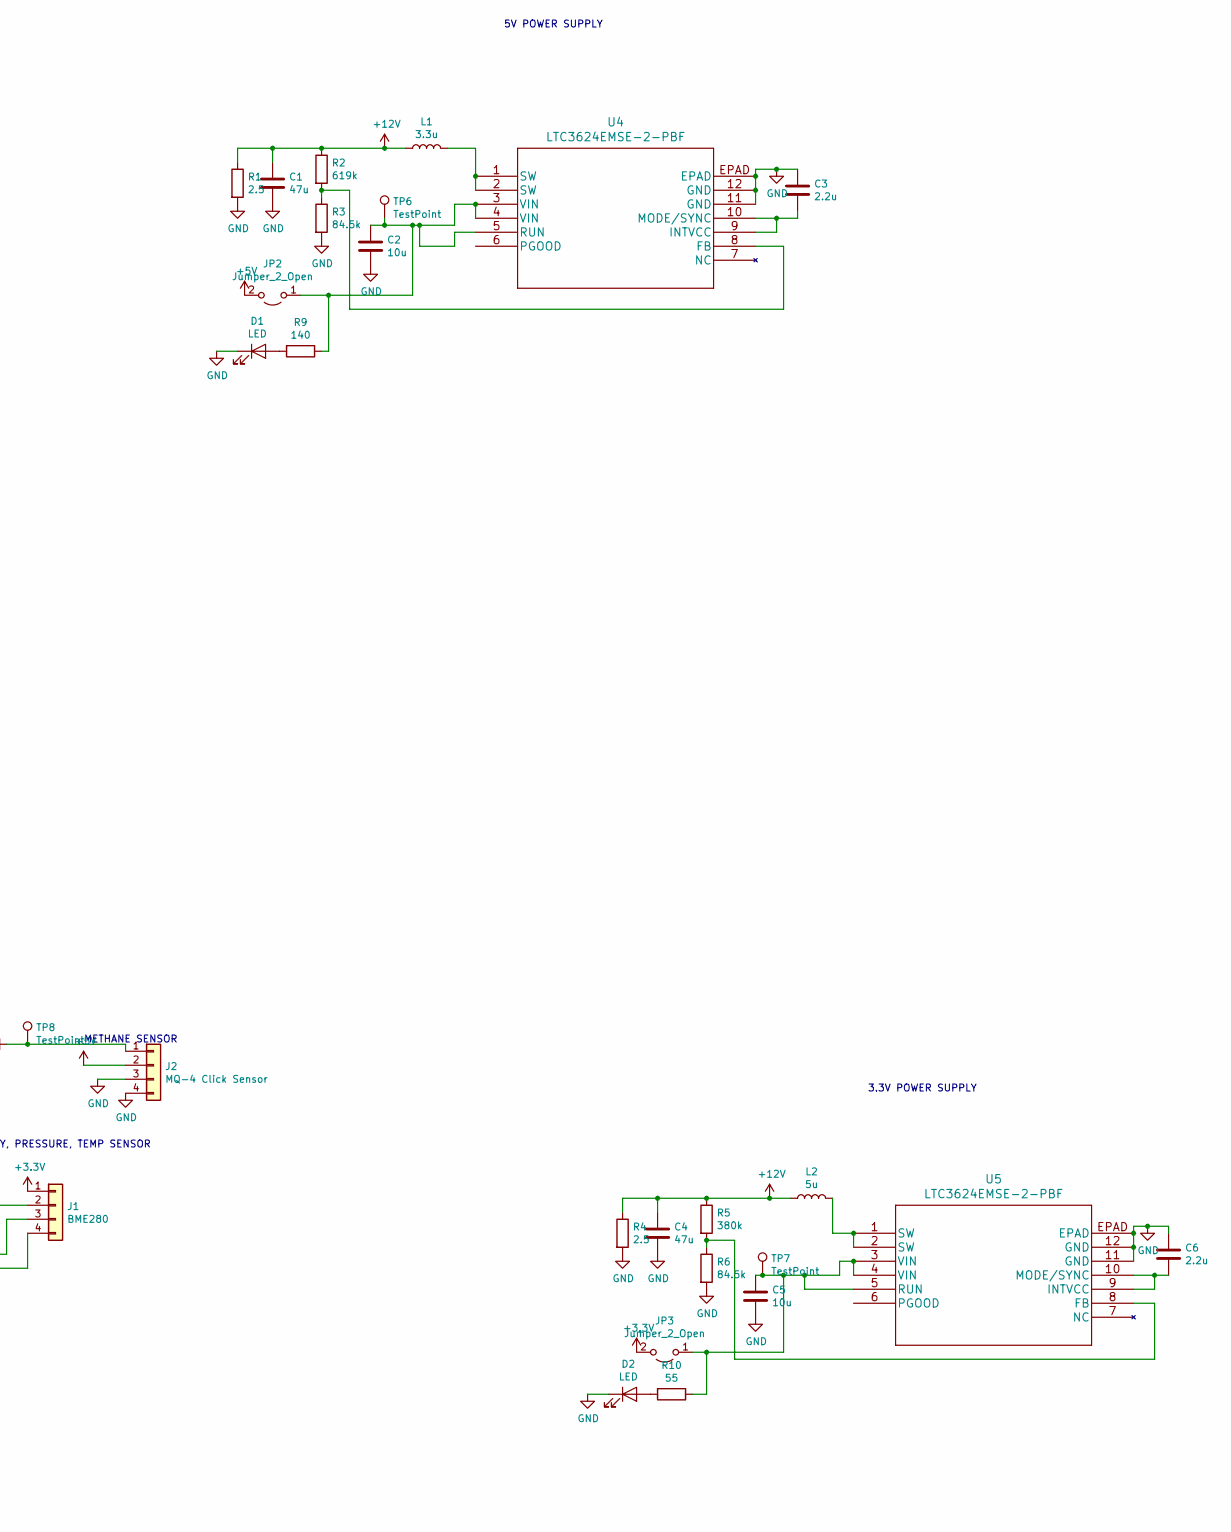
[picture p37: schematic Raitong_Env_Sensor.sch, part in row 1, column 2]

Parts:
BT1: Battery_Cell; BatteryHolder_Keystone_1058_1x2032
C1, C4: 47u; C_0402_1005Metric
C2, C5: 10u; C_0402_1005Metric
C3, C6: 2.2u; C_0402_1005Metric
D1, D2: LED; LED_0603_1608Metric
J1: BME280; PinSocket_1x04_P2.54mm_Vertical_SMD_Pin1Left
J2: MQ-4 Click Sensor; PinSocket_1x04_P2.54mm_Vertical_SMD_Pin1Left
J3: TSL2561; PinSocket_1x07_P2.54mm_Vertical_SMD_Pin1Left
J4: SPI; PinSocket_1x07_P2.54mm_Vertical_SMD_Pin1Left
J5: I2C; PinSocket_1x05_P2.54mm_Vertical_SMD_Pin1Left
J6: Analog; PinSocket_1x09_P2.54mm_Vertical_SMD_Pin1Left
J7: Relay pins; PinSocket_1x04_P2.54mm_Vertical_SMD_Pin1Left
JP1, JP2, JP3: Jumper_2_Open; SolderJumper-2_P1.3mm_Open_Pad1.0x1.5mm
L1: 3.3u; L_0402_1005Metric
L2: 5u; L_0402_1005Metric
R1, R4: 2.5; R_0402_1005Metric
R2: 619k; R_0402_1005Metric
R3, R6: 84.5k; R_0402_1005Metric
R5: 380k; R_0402_1005Metric
R7: 10k; R_0402_1005Metric
R8: 20k; R_0402_1005Metric
R9: 140; R_0402_1005Metric
R10: 55; R_0402_1005Metric
TP1, TP2, TP3, TP4, TP5, TP6, TP7, TP8: TestPoint; TestPoint_Pad_D1.5mm
U1: Teensy3.5; Teensy35_36
U3: XBEE; Xbee_Header_SMD
U4, U5: LTC3624EMSE-2-PBF

Connections:
+3V3: J1.1, J3.3, J4.6, J5.4, J6.8, JP3.2 (B)
+5V: J2.2, J4.7, J5.5, J6.9, J7.2, JP2.2 (B), U1.53 (Vin), U3.1 (VCC)
+12V: C1.1, C4.1, JP1.2 (B), L1.1, L2.1, R1.1, R2.1, R4.1, R5.1
GND: BT1.2 (-), C1.2, C2.2, C3.1, C4.2, C5.2, C6.1, D1.1 (K), D2.1 (K), J1.2, J2.3, J2.4, J3.2, J4.5, J5.3, J6.1, J6.7, J7.4, R1.2, R3.2, R4.2, R6.2, R8.2, TP3.1, U1.27 (GND), U3.10 (GND), U4.11 (GND), U4.12 (GND), U4.EPAD, U5.11 (GND), U5.12 (GND), U5.EPAD
unnamed: BT1.1 (+), U1.25 (VBat)
unnamed: C2.1, JP2.1 (A), R9.1, TP6.1, U4.3 (VIN), U4.4 (VIN), U4.5 (RUN)
unnamed: C3.2, U4.9 (INTVCC), U4.10 (MODE/SYNC)
unnamed: C5.1, JP3.1 (A), R10.1, TP7.1, U5.3 (VIN), U5.4 (VIN), U5.5 (RUN)
unnamed: C6.2, U5.9 (INTVCC), U5.10 (MODE/SYNC)
unnamed: D1.2 (A), R9.2
unnamed: D2.2 (A), R10.2
unnamed: J1.3, TP4.1, U1.46 (19_A5_SCL0_Touch)
unnamed: J1.4, TP5.1, U1.45 (18_A4_SDA0_Touch)
unnamed: J2.1, R7.1, TP8.1
unnamed: J3.6, U1.35 (38_A19_PWM_SDA1)
unnamed: J3.7, U1.34 (37_A18_PWM_SCL1)
unnamed: J4.1, U1.24 (32_A13_TX4_SCK1)
unnamed: J4.2, U1.11 (9_PWM_RX2_CS0)
unnamed: J4.3, U1.14 (12_MISO0)
unnamed: J4.4, U1.13 (11_MOSI0)
unnamed: J5.1, U1.10 (8_TX3_miso0_sda0)
unnamed: J5.2, U1.9 (7_RX3_miso0_scl0)
unnamed: J6.2, U1.55 (AREF)
unnamed: J6.3, U1.52 (AGND)
unnamed: J6.4, U1.32 (35_A16_PWM)
unnamed: J6.5, U1.31 (34_A15_CAN1TX_sda0)
unnamed: J6.6, U1.30 (33_A14_CAN1TX_scl0)
unnamed: J7.1, JP1.1 (A)
unnamed: L1.2, U4.1 (SW), U4.2 (SW)
unnamed: L2.2, U5.1 (SW), U5.2 (SW)
unnamed: R2.2, R3.1, U4.8 (FB)
unnamed: R5.2, R6.1, U5.8 (FB)
unnamed: R7.2, R8.1, U1.47 (20_A6_PWM_CS0_sck1)
unnamed: TP1.1, U1.3 (1_TX1_MISO1_Touch), U3.3 (DIN)
unnamed: TP2.1, U1.2 (0_RX1_MOSI1_Touch), U3.2 (DOUT)

Notes on the sheet:
12/3
HUMIDITY, PRESSURE, TEMP SENSOR
METHANE SENSOR
LORA XBEE SOCKET
AMBIENT LIGHT SENSOR
RAITONG ORGANICS ENVIRONMENTAL SENSOR TRANSMITTER
3.3V POWER SUPPLY
5V POWER SUPPLY
Spare Ports

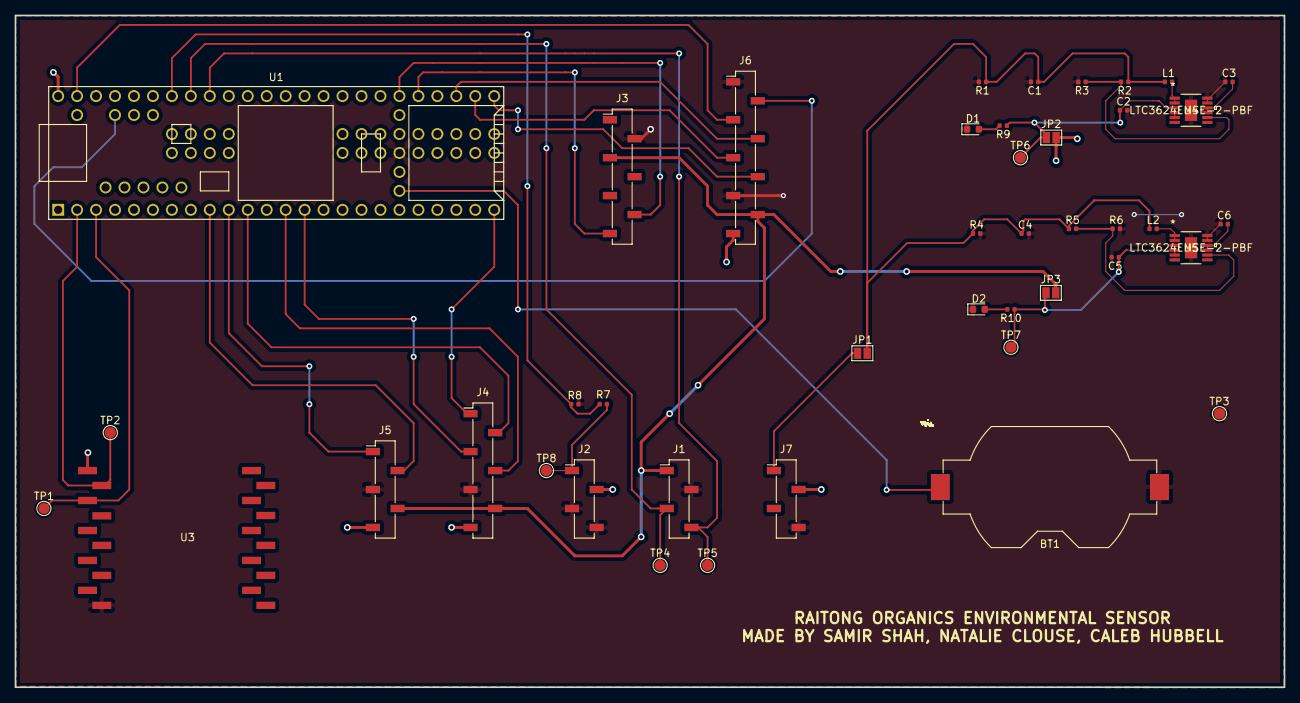
[picture p38: board Raitong_Env_Sensor.kicad_pcb from above]

Board: 2 copper layers, 170.0 x 90.0 mm, 43 parts (0 on the bottom side), 35 nets.
