hubbellc/ECE44x/PCB/Power/sdvoltagereg/sdvoltagereg.kicad_pcb

## KiCad design PCB/Power/sdvoltagereg/sdvoltagereg.kicad_pcb (2019-05-28)

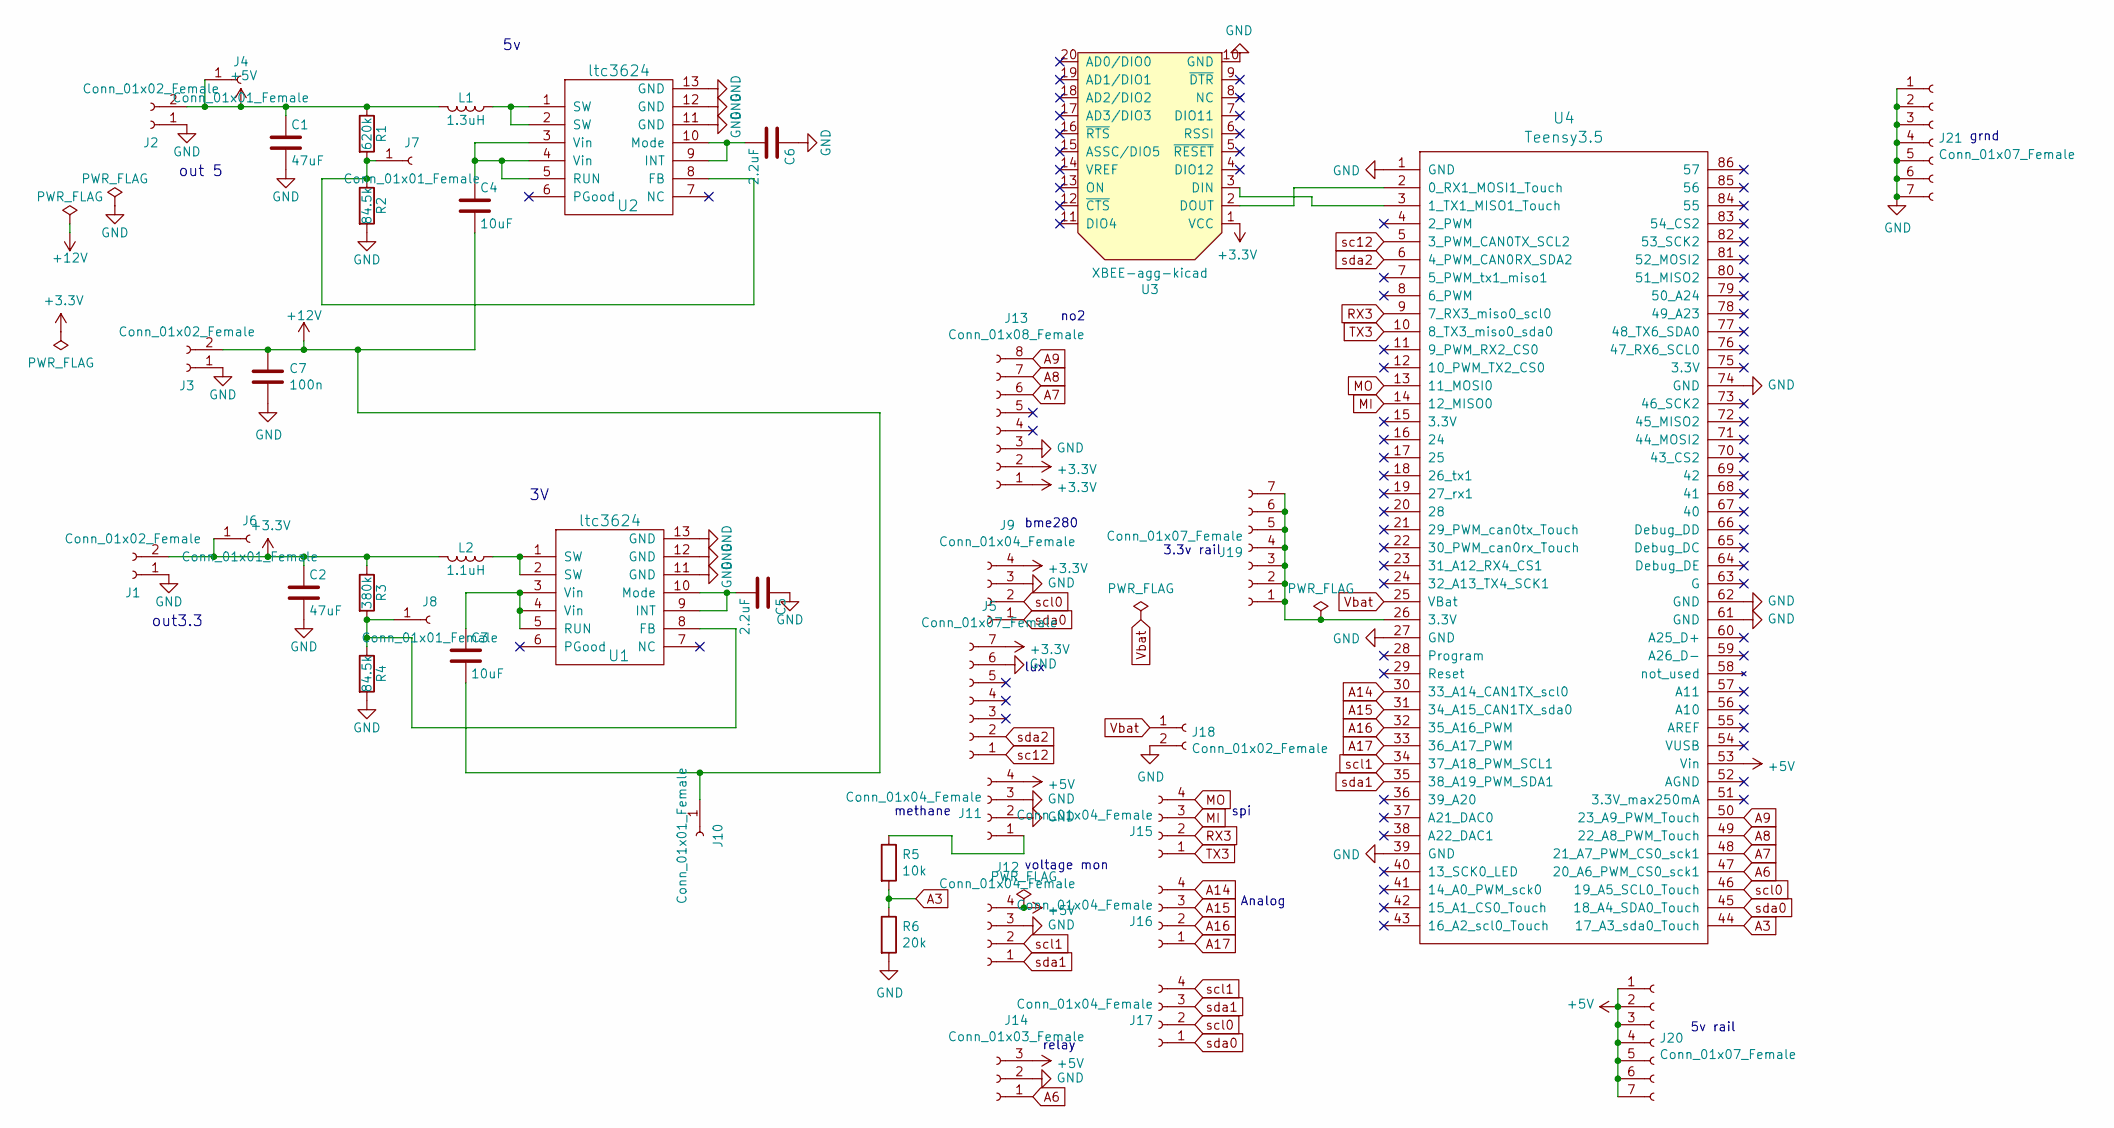
[picture p39: schematic sdvoltagereg.sch]

Parts:
C1, C2: 47uF; R_1210_HandSoldering
C3, C4: 10uF; R_0603_HandSoldering
C5, C6: 2.2uF; R_1210_HandSoldering
C7: 100n; C_0603_HandSoldering
J1, J2, J3, J18: Conn_01x02_Female; Pin_Header_Straight_1x02_Pitch2.54mm
J4, J6, J7, J8, J10: Conn_01x01_Female; Pin_Header_Straight_1x01_Pitch2.54mm
J5, J19, J20, J21: Conn_01x07_Female; Pin_Header_Straight_1x07_Pitch2.54mm
J9, J11, J12, J15, J16, J17: Conn_01x04_Female; Pin_Header_Straight_1x04_Pitch2.54mm
J13: Conn_01x08_Female; Pin_Header_Straight_1x08_Pitch2.54mm
J14: Conn_01x03_Female; Pin_Header_Straight_1x03_Pitch2.54mm
L1: 1.3uH; L_0805_HandSoldering
L2: 1.1uH; L_0805_HandSoldering
R1: 620k; R_0603_HandSoldering
R2, R4: 84.5k; R_0402
R3: 380k; R_0603_HandSoldering
R5: 10k; R_0603_HandSoldering
R6: 20k; R_0603_HandSoldering
U1, U2: ltc3624; SOP65P490X110-13N
U3: XBEE-agg-kicad; XBEE
U4: Teensy3.5; Teensy35_36

Connections:
+3V3: C2.1, J1.2, J5.7, J6.1, J9.4, J13.1, J13.2, L2.2, R3.1, U3.1 (VCC)
+5V: C1.1, J2.2, J4.1, J11.4, J12.4, J14.3, J20.1, J20.2, J20.3, J20.4, J20.5, J20.6, J20.7, L1.2, R1.1, U4.53 (Vin)
+12V: C3.2, C4.2, C7.1, J3.2, J10.1
A3: R5.2, R6.1, U4.44 (17_A3_sda0_Touch)
A6: J14.1, U4.47 (20_A6_PWM_CS0_sck1)
A7: J13.6, U4.48 (21_A7_PWM_CS0_sck1)
A8: J13.7, U4.49 (22_A8_PWM_Touch)
A9: J13.8, U4.50 (23_A9_PWM_Touch)
A14: J16.4, U4.30 (33_A14_CAN1TX_scl0)
A15: J16.3, U4.31 (34_A15_CAN1TX_sda0)
A16: J16.2, U4.32 (35_A16_PWM)
A17: J16.1, U4.33 (36_A17_PWM)
GND: C1.2, C2.2, C5.1, C6.1, C7.2, J1.1, J2.1, J3.1, J5.6, J9.3, J11.2, J11.3, J12.3, J13.3, J14.2, J18.2, J21.1, J21.2, J21.3, J21.4, J21.5, J21.6, J21.7, R2.2, R4.2, R6.2, U1.11 (GND), U1.12 (GND), U1.13 (GND), U2.11 (GND), U2.12 (GND), U2.13 (GND), U3.10 (GND), U4.1 (GND), U4.27 (GND), U4.39 (GND), U4.61 (GND), U4.62 (GND), U4.74 (GND)
MI: J15.3, U4.14 (12_MISO0)
MO: J15.4, U4.13 (11_MOSI0)
unnamed: C3.1, U1.3 (Vin), U1.4 (Vin), U1.5 (RUN)
unnamed: C4.1, U2.3 (Vin), U2.4 (Vin), U2.5 (RUN)
unnamed: C5.2, U1.9 (INT), U1.10 (Mode)
unnamed: C6.2, U2.9 (INT), U2.10 (Mode)
unnamed: J7.1, R1.2, R2.1, U2.8 (FB)
unnamed: J8.1, R3.2, R4.1, U1.8 (FB)
unnamed: J11.1, R5.1
unnamed: J19.1, J19.2, J19.3, J19.4, J19.5, J19.6, J19.7, U4.26 (3.3V)
unnamed: L1.1, U2.1 (SW), U2.2 (SW)
unnamed: L2.1, U1.1 (SW), U1.2 (SW)
unnamed: U3.2 (DOUT), U4.2 (0_RX1_MOSI1_Touch)
unnamed: U3.3 (DIN), U4.3 (1_TX1_MISO1_Touch)
RX3: J15.2, U4.9 (7_RX3_miso0_scl0)
TX3: J15.1, U4.10 (8_TX3_miso0_sda0)
Vbat: J18.1, U4.25 (VBat)
sc12: J5.1, U4.5 (3_PWM_CAN0TX_SCL2)
scl0: J9.2, J17.2, U4.46 (19_A5_SCL0_Touch)
scl1: J12.2, J17.4, U4.34 (37_A18_PWM_SCL1)
sda0: J9.1, J17.1, U4.45 (18_A4_SDA0_Touch)
sda1: J12.1, J17.3, U4.35 (38_A19_PWM_SDA1)
sda2: J5.2, U4.6 (4_PWM_CAN0RX_SDA2)

Notes on the sheet:
out 5
out3.3
no2
bme280
lux
voltage mon
methane
5v rail
grnd
3.3v rail
relay
spi
Analog

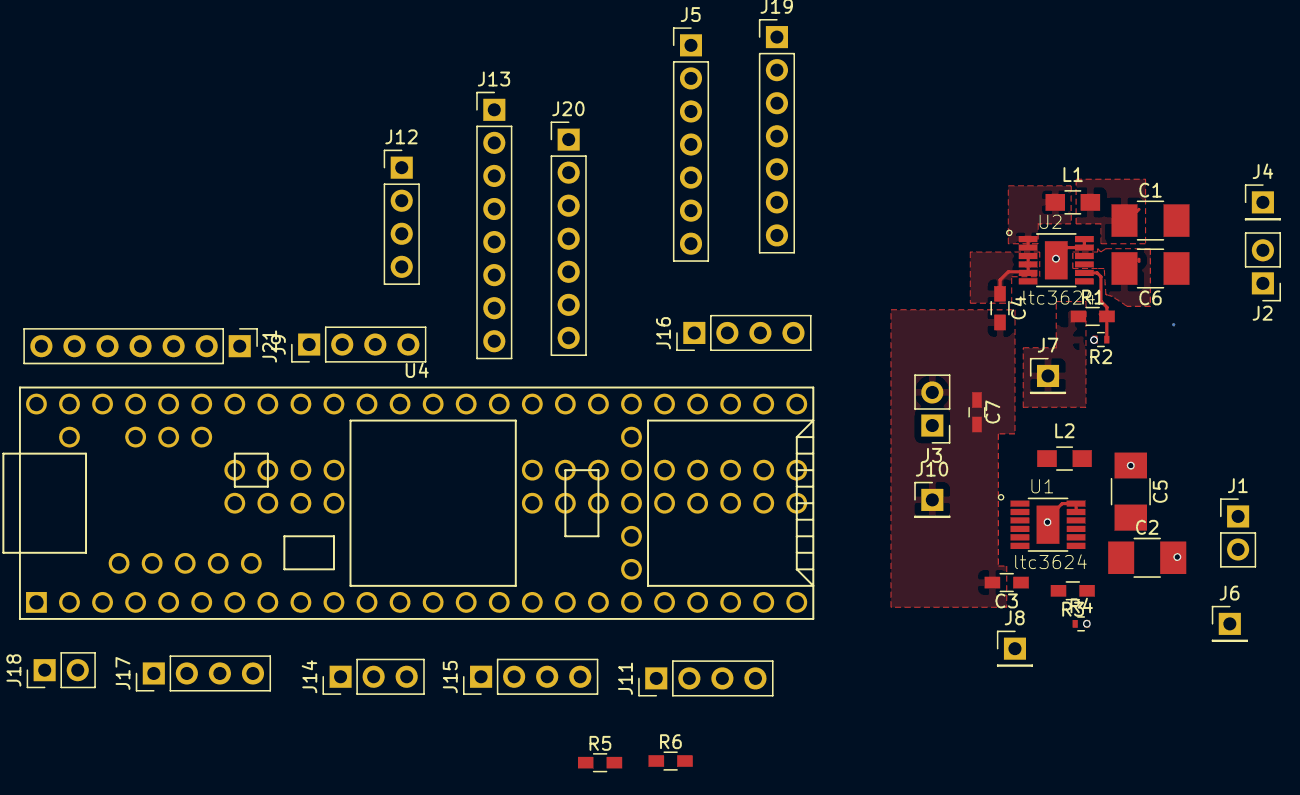
[picture p40: board sdvoltagereg.kicad_pcb from above]

Board: 2 copper layers, 39 parts (0 on the bottom side), 34 nets.
