hubbellc/ECE44x/Sensor/Sensor Processing/Sensor Code/Teensy_Sandbox/Teensy_Sandbox.ino

// program utilizes two serial ports, one to program/talk back
//   and one to talk to the Mdot
//   will relay all serial received commands to mdot, and vice-versa


/*--------------------------------------------------------------------------------------
  Includes
  --------------------------------------------------------------------------------------*/


/*--------------------------------------------------------------------------------------
  Definitions
  --------------------------------------------------------------------------------------*/



void setup() 
{
  int response;
  
  // begin comm to computer for responses (USB)
  Serial.begin(115200);

  // begin comm to Mdot (port 0 and 1)
  Serial1.begin(115200);

  delay(1000);
}

void loop() 
{
  //if (Serial.available()) Serial1.write(Serial.read()); // WORKS!
  //Serial.println("waiting");
  Serial1.write("AT\n");
  Serial1.flush();

  
  //Serial.println("waiting2");
  Serial.write(Serial1.read());
  Serial.flush();
  delay(100);
}
