hubbellc/ECE44x/(commit log)

2019-01-11 Added wiring schematics
2019-02-04 Sensor housing designed
    [AC Plug.SLDPRT, Antenna.SLDPRT, Base.SLDPRT, DC Plug.SLDPRT, Door.SLDPRT, Gecko.SLDPRT, Light sensor.SLDPRT, PCB.SLDPRT]
2019-02-14 Revised Housing
    STL's have been sent to print. This is the final version.
    [AC Plug.SLDPRT, Antenna.SLDPRT, BOM.xlsx, Base.SLDPRT, Base.STL, Door.SLDPRT, Door.STL, Gecko.SLDPRT]
2019-02-22 Final modifcations before block checkoff
    [Base.SLDPRT, House on post.SLDASM, Roof.SLDPRT, Roof.STL, Roof1.STL, Roof1.sldprt, Roof2.STL, Roof2.sldprt]
2019-04-10 Sensor housing V2.0
    [Base.SLDPRT, Base.STL, Door no logo.DXF, Door no logo.SLDPRT, Door.SLDPRT, Door.STL, PCB Holder.SLDPRT, PCB Holder.STL]
2019-04-10 Natalies code
    This is code for the relay,temp/hum sensor and no2 sensor
2019-04-19 added light sensor
    added light sensor
2019-04-19 Added relay code
2019-04-22 Updated Housing with new PCB design
    [Light sensor washers.SLDPRT, Light sensor.SLDPRT, PCB.SLDASM, Sensor Housing.SLDASM]
2019-04-23 light sensor files fixed
2019-04-23 Code cleanup
    Updated wireless protocol to include ACK's. Updated sensor configs to try for 30 seconds.
    [Simple_RangeCalc_V1.1.xlsx]
2019-04-27 Teensy rev
2019-04-27 Merged teensy code
2019-05-28 Reorganization
    All files utilized in the design process should now be on github or hackster.
    [AC Plug.SLDPRT, Antenna.SLDPRT, BOM.xlsx, Base.SLDPRT, Base.STL, Considerations.xlsx, DC Plug.SLDPRT, Door no logo.DXF]
2019-09-17 Working Teensy Code
2019-09-18 Final Teensy code cleanup
2019-09-18 final push of updated sensor data
2019-09-18 Improved sensor pi code
